z80/digitizer/software/digitizer/src/images/exec.jpeg

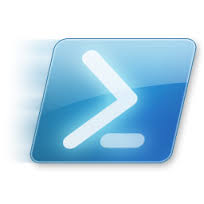
software/digitizer/src/images/exec.jpeg
