z80/digitizer/doc/socket 5 pin.pdf

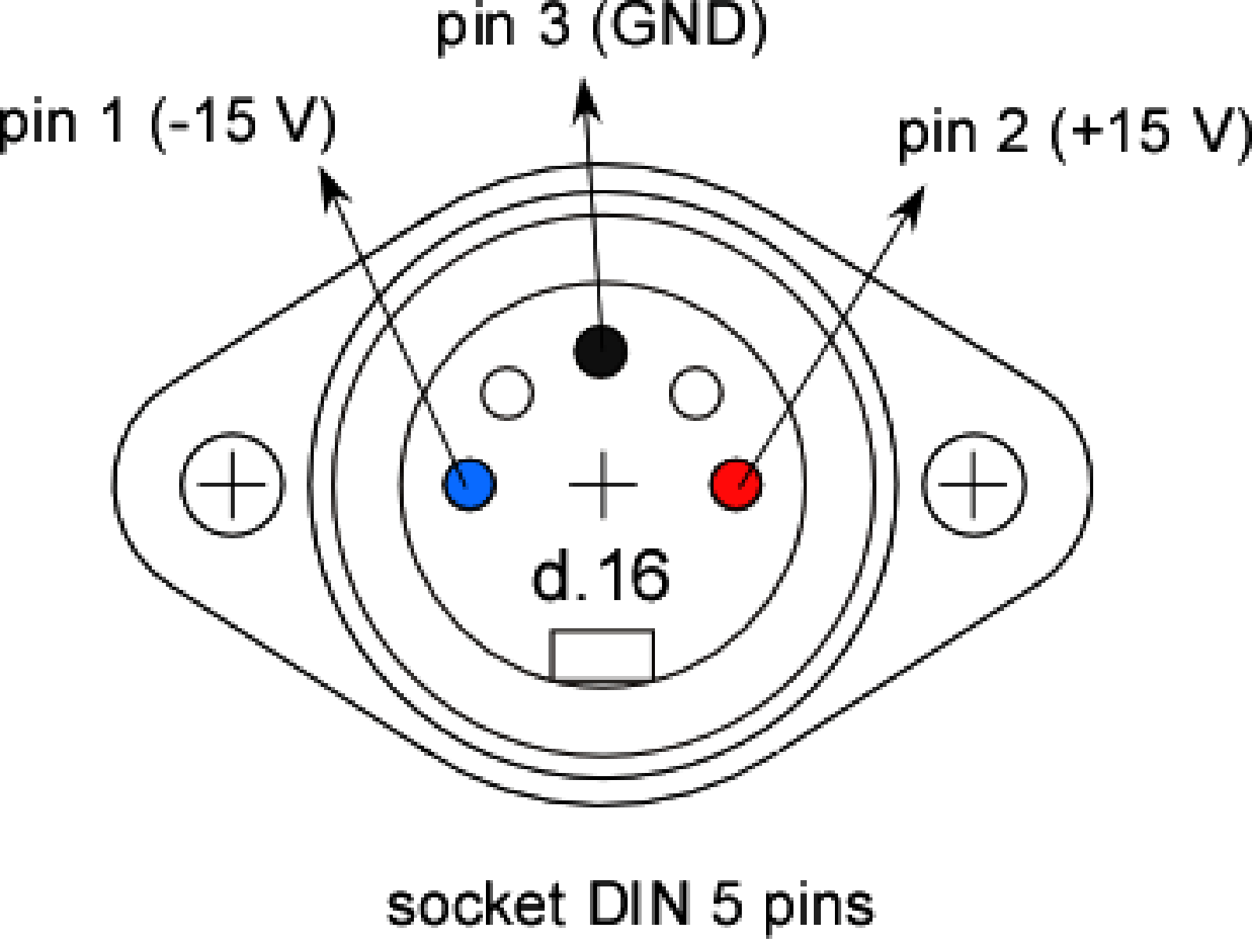
[picture p6: page 1]
