z80/digitizer/doc/mendeleev.jpg

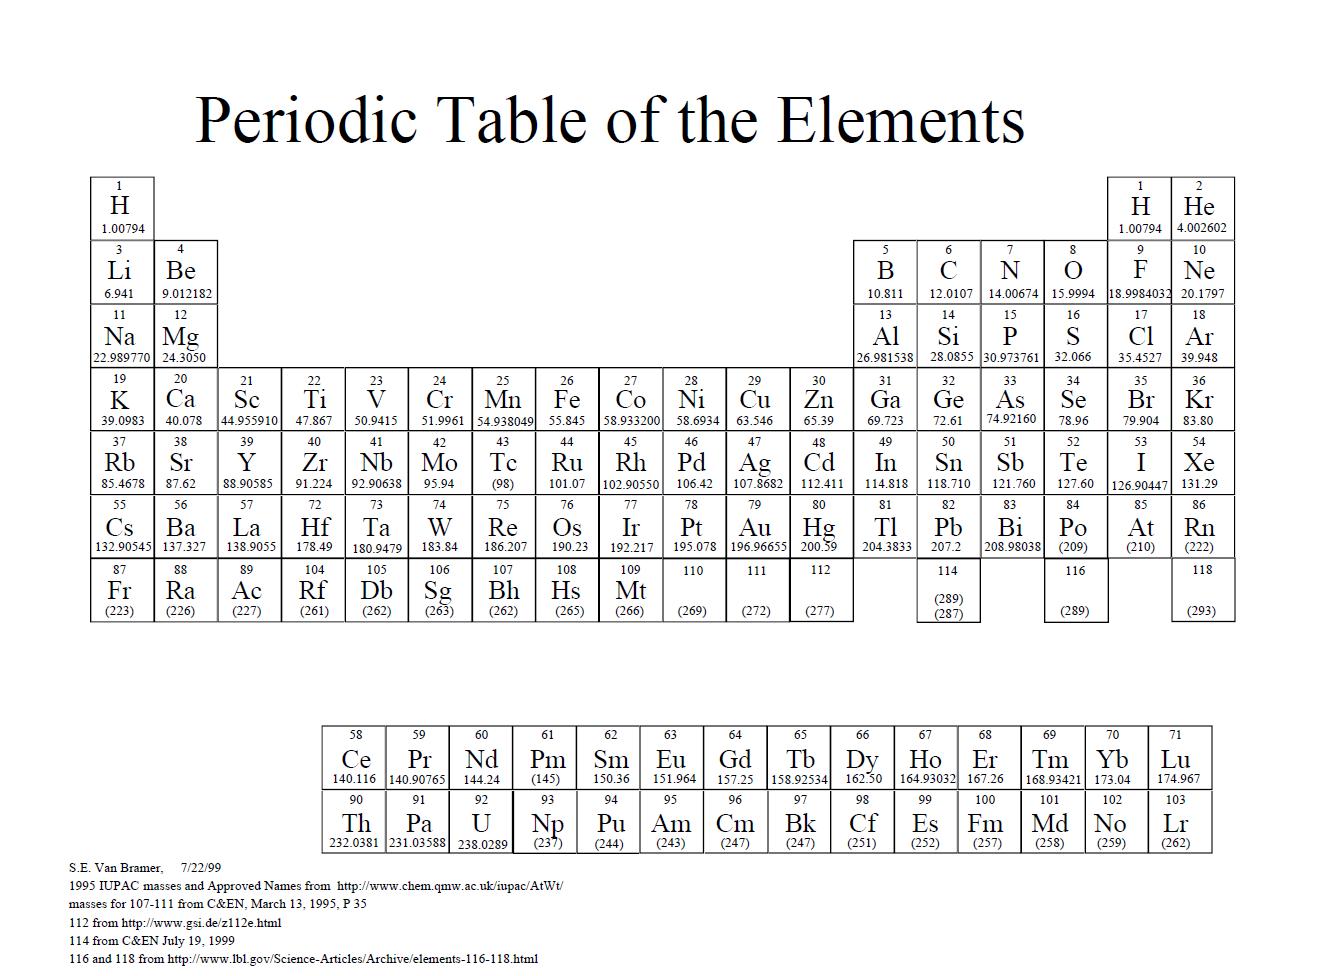
doc/mendeleev.jpg
