z80/digitizer/software/digitizer/src/images/out-relay.png

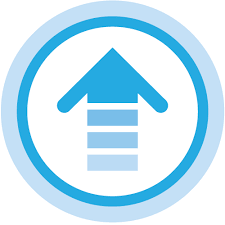
software/digitizer/src/images/out-relay.png
