z80/digitizer/software/help/content/html/about-dlg.png

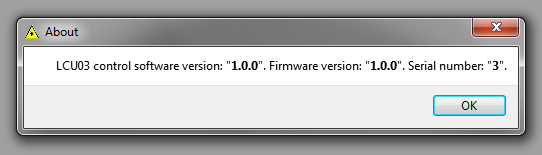
software/help/content/html/about-dlg.png
