z80/digitizer/software/help/content/html/device-selection.png

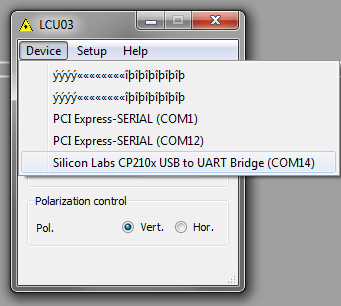
software/help/content/html/device-selection.png
