z80/digitizer/software/help/content/html/driver-folder.png

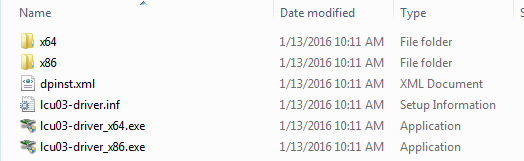
software/help/content/html/driver-folder.png
