z80/digitizer/software/help/content/html/firmware-upgrade.png

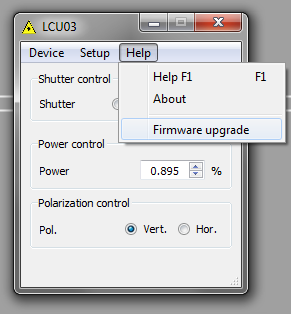
software/help/content/html/firmware-upgrade.png
