z80/digitizer/software/help/content/html/main-wnd.png

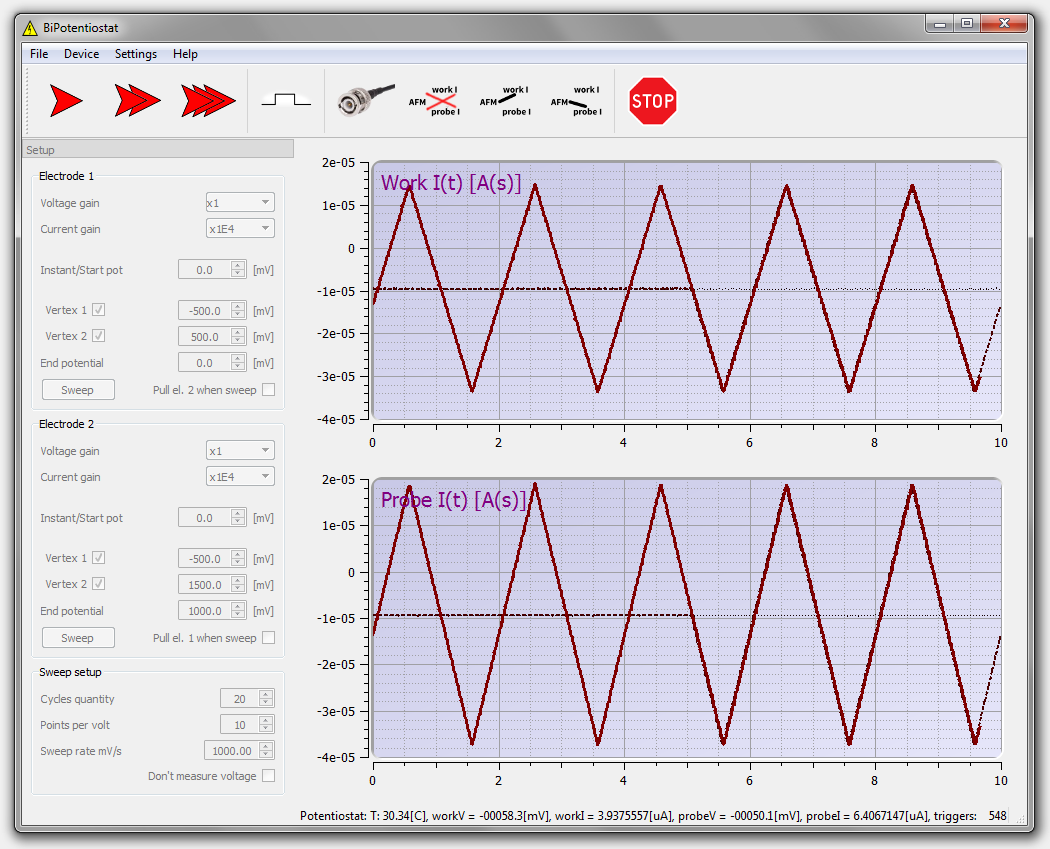
software/help/content/html/main-wnd.png
