z80/digitizer/software/help/content/html/remote-ctrl-dlg.png

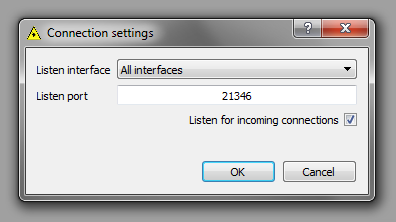
software/help/content/html/remote-ctrl-dlg.png
