z80/digitizer/software/help/content/html/sweep-wnd.png

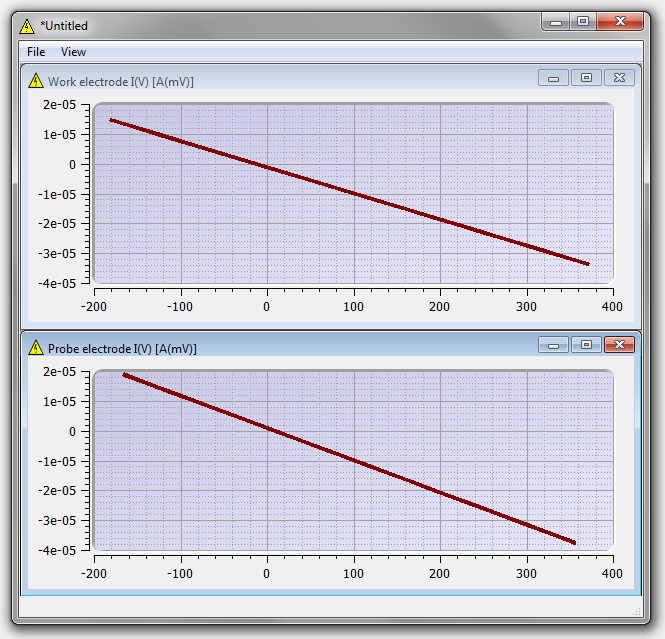
software/help/content/html/sweep-wnd.png
