z80/digitizer/doc/bnc-socket/031-5431-10rfx.igs

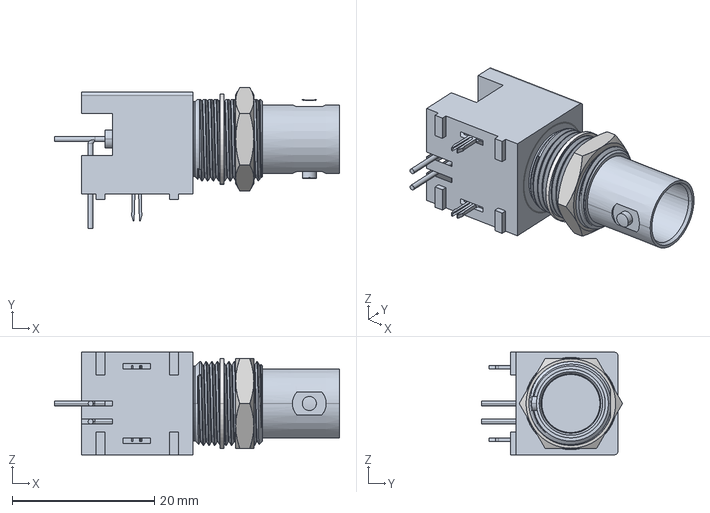
[picture p19: CAD file, 2015-08-29]
doc/bnc-socket/031-5431-10rfx.igs
40.0 x 19.8 x 14.4 mm
