z80/digitizer/drawing/bottom.stl

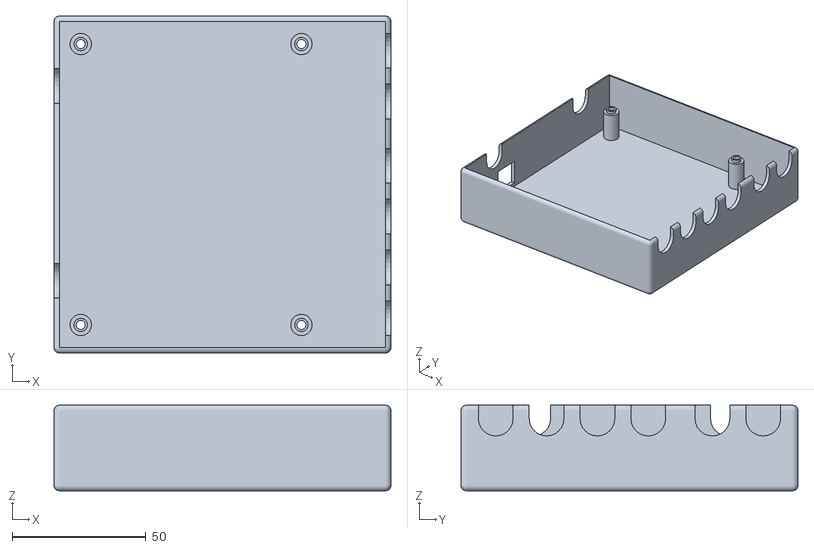
[picture p20: CAD file, 2015-08-29]
drawing/bottom.stl
126.0 x 126.0 x 32.0
