z80/digitizer/drawing/top.stl

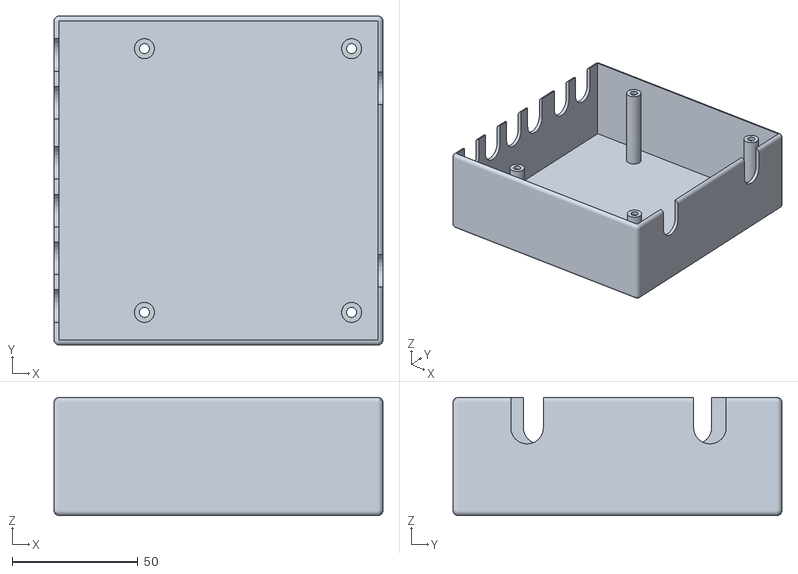
[picture p21: CAD file, 2015-08-29]
drawing/top.stl
131.0 x 131.0 x 47.0
