z80/digitizer/drawing/board.FCStd

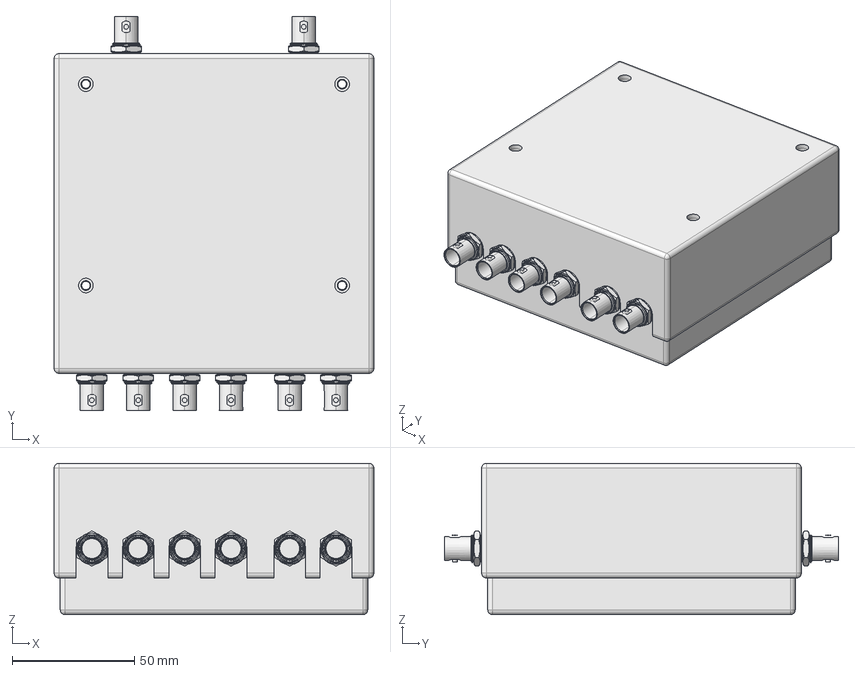
[picture p22: CAD file, 2015-08-29]
drawing/board.FCStd
131.0 x 161.4 x 62.0 mm
board
bnc
bnc02
bnc03
bnc04
bnc05
bnc06
bnc07
usb
bnc08
bottom-v02
top-v2
