z80/digitizer/drawing/washer.FCStd

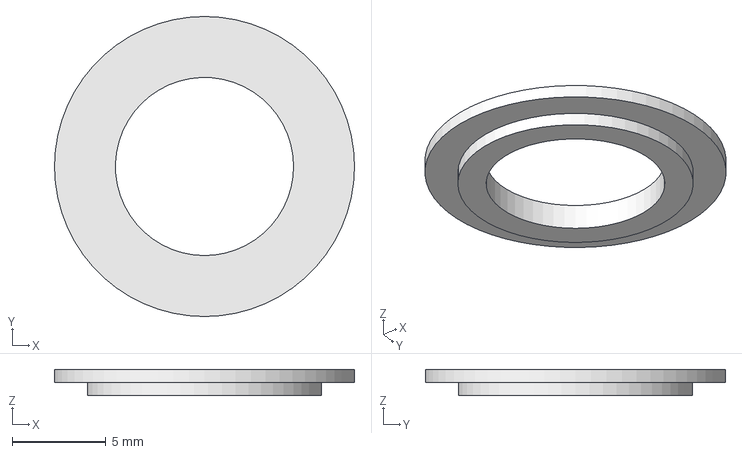
[picture p23: CAD file, 2015-08-29]
drawing/washer.FCStd
16.0 x 16.0 x 1.40 mm
