z80/digitizer/(list of files, cad)

Other CAD files:
firmware/chibios_2.4.x/demos/STM8L-STM8L152-DISCOVERY-STVD/cosmic/cosmic.stp
firmware/chibios_2.4.x/demos/STM8L-STM8L152-DISCOVERY-STVD/raisonance/raisonance.stp
firmware/chibios_2.4.x/demos/STM8S-STM8S105-DISCOVERY-STVD/cosmic/cosmic.stp
firmware/chibios_2.4.x/demos/STM8S-STM8S105-DISCOVERY-STVD/raisonance/raisonance.stp
firmware/chibios_2.4.x/testhal/STM8S/SPI/cosmic/cosmic.stp
firmware/chibios_2.4.x/testhal/STM8S/SPI/raisonance/raisonance.stp
firmware/digitizer/chibios_2.4.x/demos/STM8L-STM8L152-DISCOVERY-STVD/cosmic/cosmic.stp
firmware/digitizer/chibios_2.4.x/demos/STM8L-STM8L152-DISCOVERY-STVD/raisonance/raisonance.stp
firmware/digitizer/chibios_2.4.x/demos/STM8S-STM8S105-DISCOVERY-STVD/cosmic/cosmic.stp
firmware/digitizer/chibios_2.4.x/demos/STM8S-STM8S105-DISCOVERY-STVD/raisonance/raisonance.stp
firmware/digitizer/chibios_2.4.x/testhal/STM8S/SPI/cosmic/cosmic.stp
firmware/digitizer/chibios_2.4.x/testhal/STM8S/SPI/raisonance/raisonance.stp
drawing/washer.stl
