z80/digitizer/software/help/content/html/setup-dlg.png

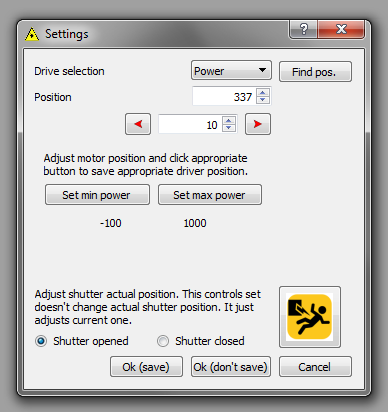
software/help/content/html/setup-dlg.png
