z80/digitizer/calc/adc-low-pass-filter.asc

C1: cap; 22n
C2: cap; 22n
C3: cap; 120n
C4: cap; 3.3µ
C5: cap; 60p
C6: cap; 3n
R1: res; 9.31k
R2: res; 21k
R3: res; 1.91k
R4: res; 806
R5: res; 10k
R6: res; 1.5k
R7: res; 10
R8: res; 3k
R9: res; 13k
R10: res; 10k
U1: UniversalOpamp2
U2: UniversalOpamp2
U3: UniversalOpamp2
U4: UniversalOpamp2
V1: voltage; SINE(0 10 3000); AC 1.
V2: voltage; 12
V3: voltage; 12
V4: voltage; PULSE(0 1 1u 0 0 1u 2u 100)
V5: voltage; 3.3
Named nets: 0, out, in, v+, v-, cmp, test, tst-in
.tran 20u
