z80/digitizer/electrical/relay-board/relay-board.kicad_pcb

## KiCad design electrical/relay-board/relay-board.kicad_pcb (2015-08-29)

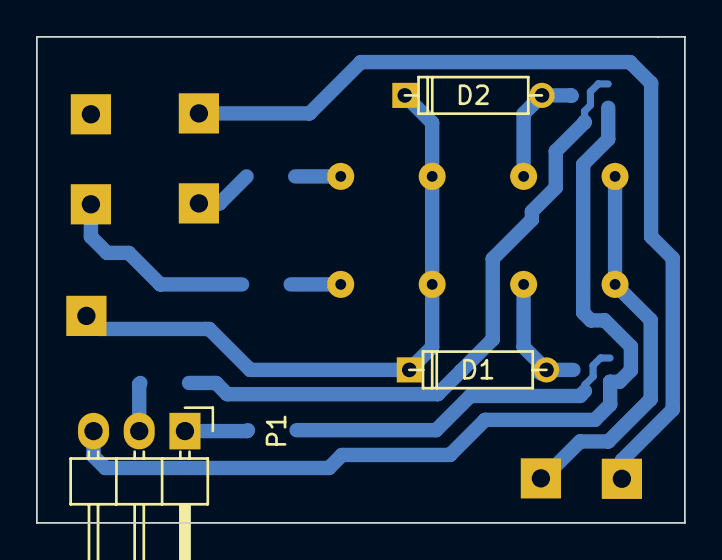
[picture p31: board relay-board.kicad_pcb from above]

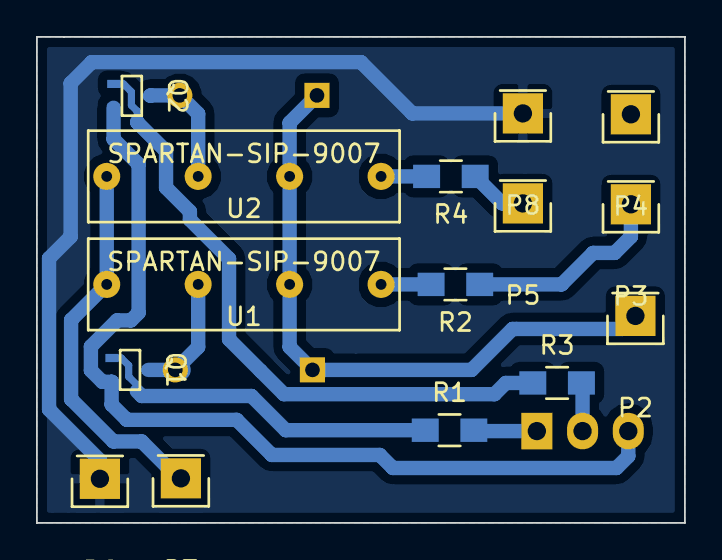
[picture p32: board relay-board.kicad_pcb from below]

Board: 2 copper layers, 36.0 x 27.0 mm, 18 parts (15 on the bottom side), 14 nets.

Parts:
D1, D2: 1n5819; D3
P1: CONN_01X03; Pin_Header_Angled_1x03
P2: 12V; Pin_Header_Straight_1x01
P3, P4: work; Pin_Header_Straight_1x01
P5, P6: probe; Pin_Header_Straight_1x01
P7: output; Pin_Header_Straight_1x01
P8: output gnd; Pin_Header_Straight_1x01
Q1, Q2: bc847; sot23
R1, R2, R3, R4: 1k 5%; R_0805_HandSoldering
U1, U2: SPARTAN-SIP-9007

Connections:
+12V: D1.1, D2.1, P2.1, U1.2, U2.2
/probeEn: P1.1, R1.2
/probeI: P3.1, R2.1
/workEn: P1.2, R3.2
/workI: P5.1, R4.1
GND: P1.3, Q1.3, Q2.3
GNDA: P6.1, P8.1
unnamed: D1.2, Q1.2, U1.3
unnamed: D2.2, Q2.2, U2.3
unnamed: P7.1, U1.4, U2.4
unnamed: Q1.1, R1.1
unnamed: Q2.1, R3.1
unnamed: R2.2, U1.1
unnamed: R4.2, U2.1
