z80/digitizer/electrical/scheme/digitizer.kicad_pcb

## KiCad design electrical/scheme/digitizer.kicad_pcb (2015-07-21)

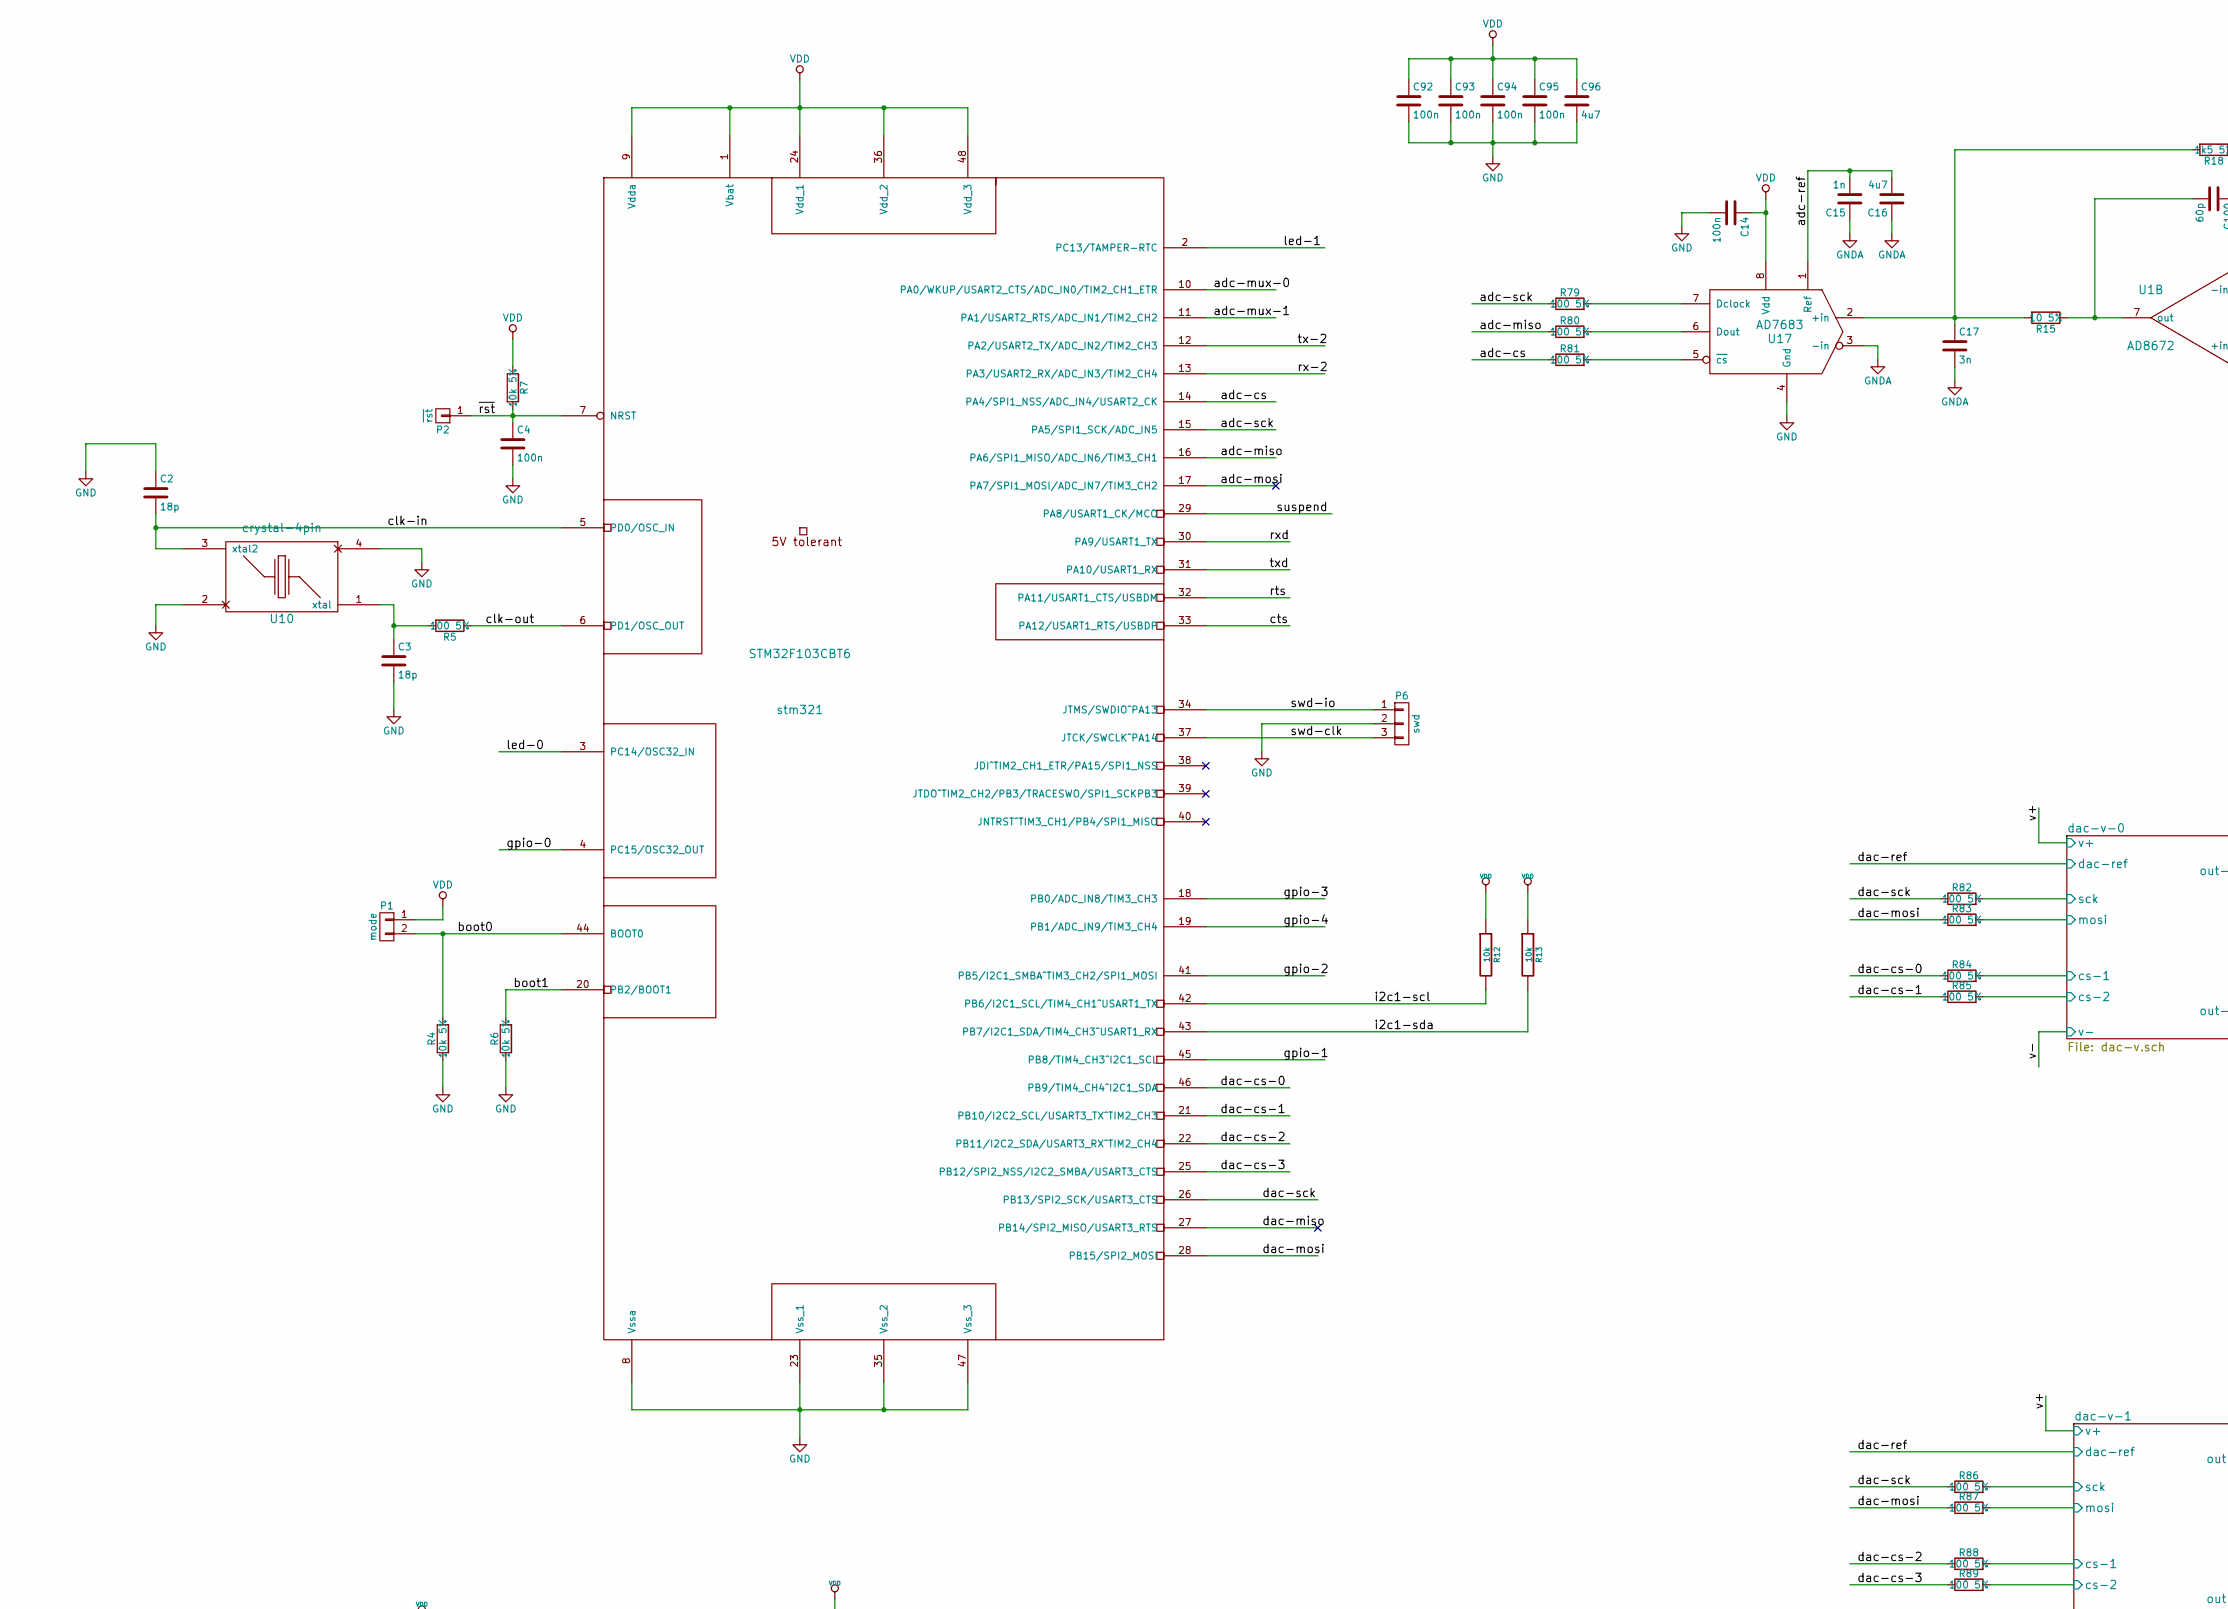
[picture p33: schematic digitizer.sch, part in row 1, column 1]

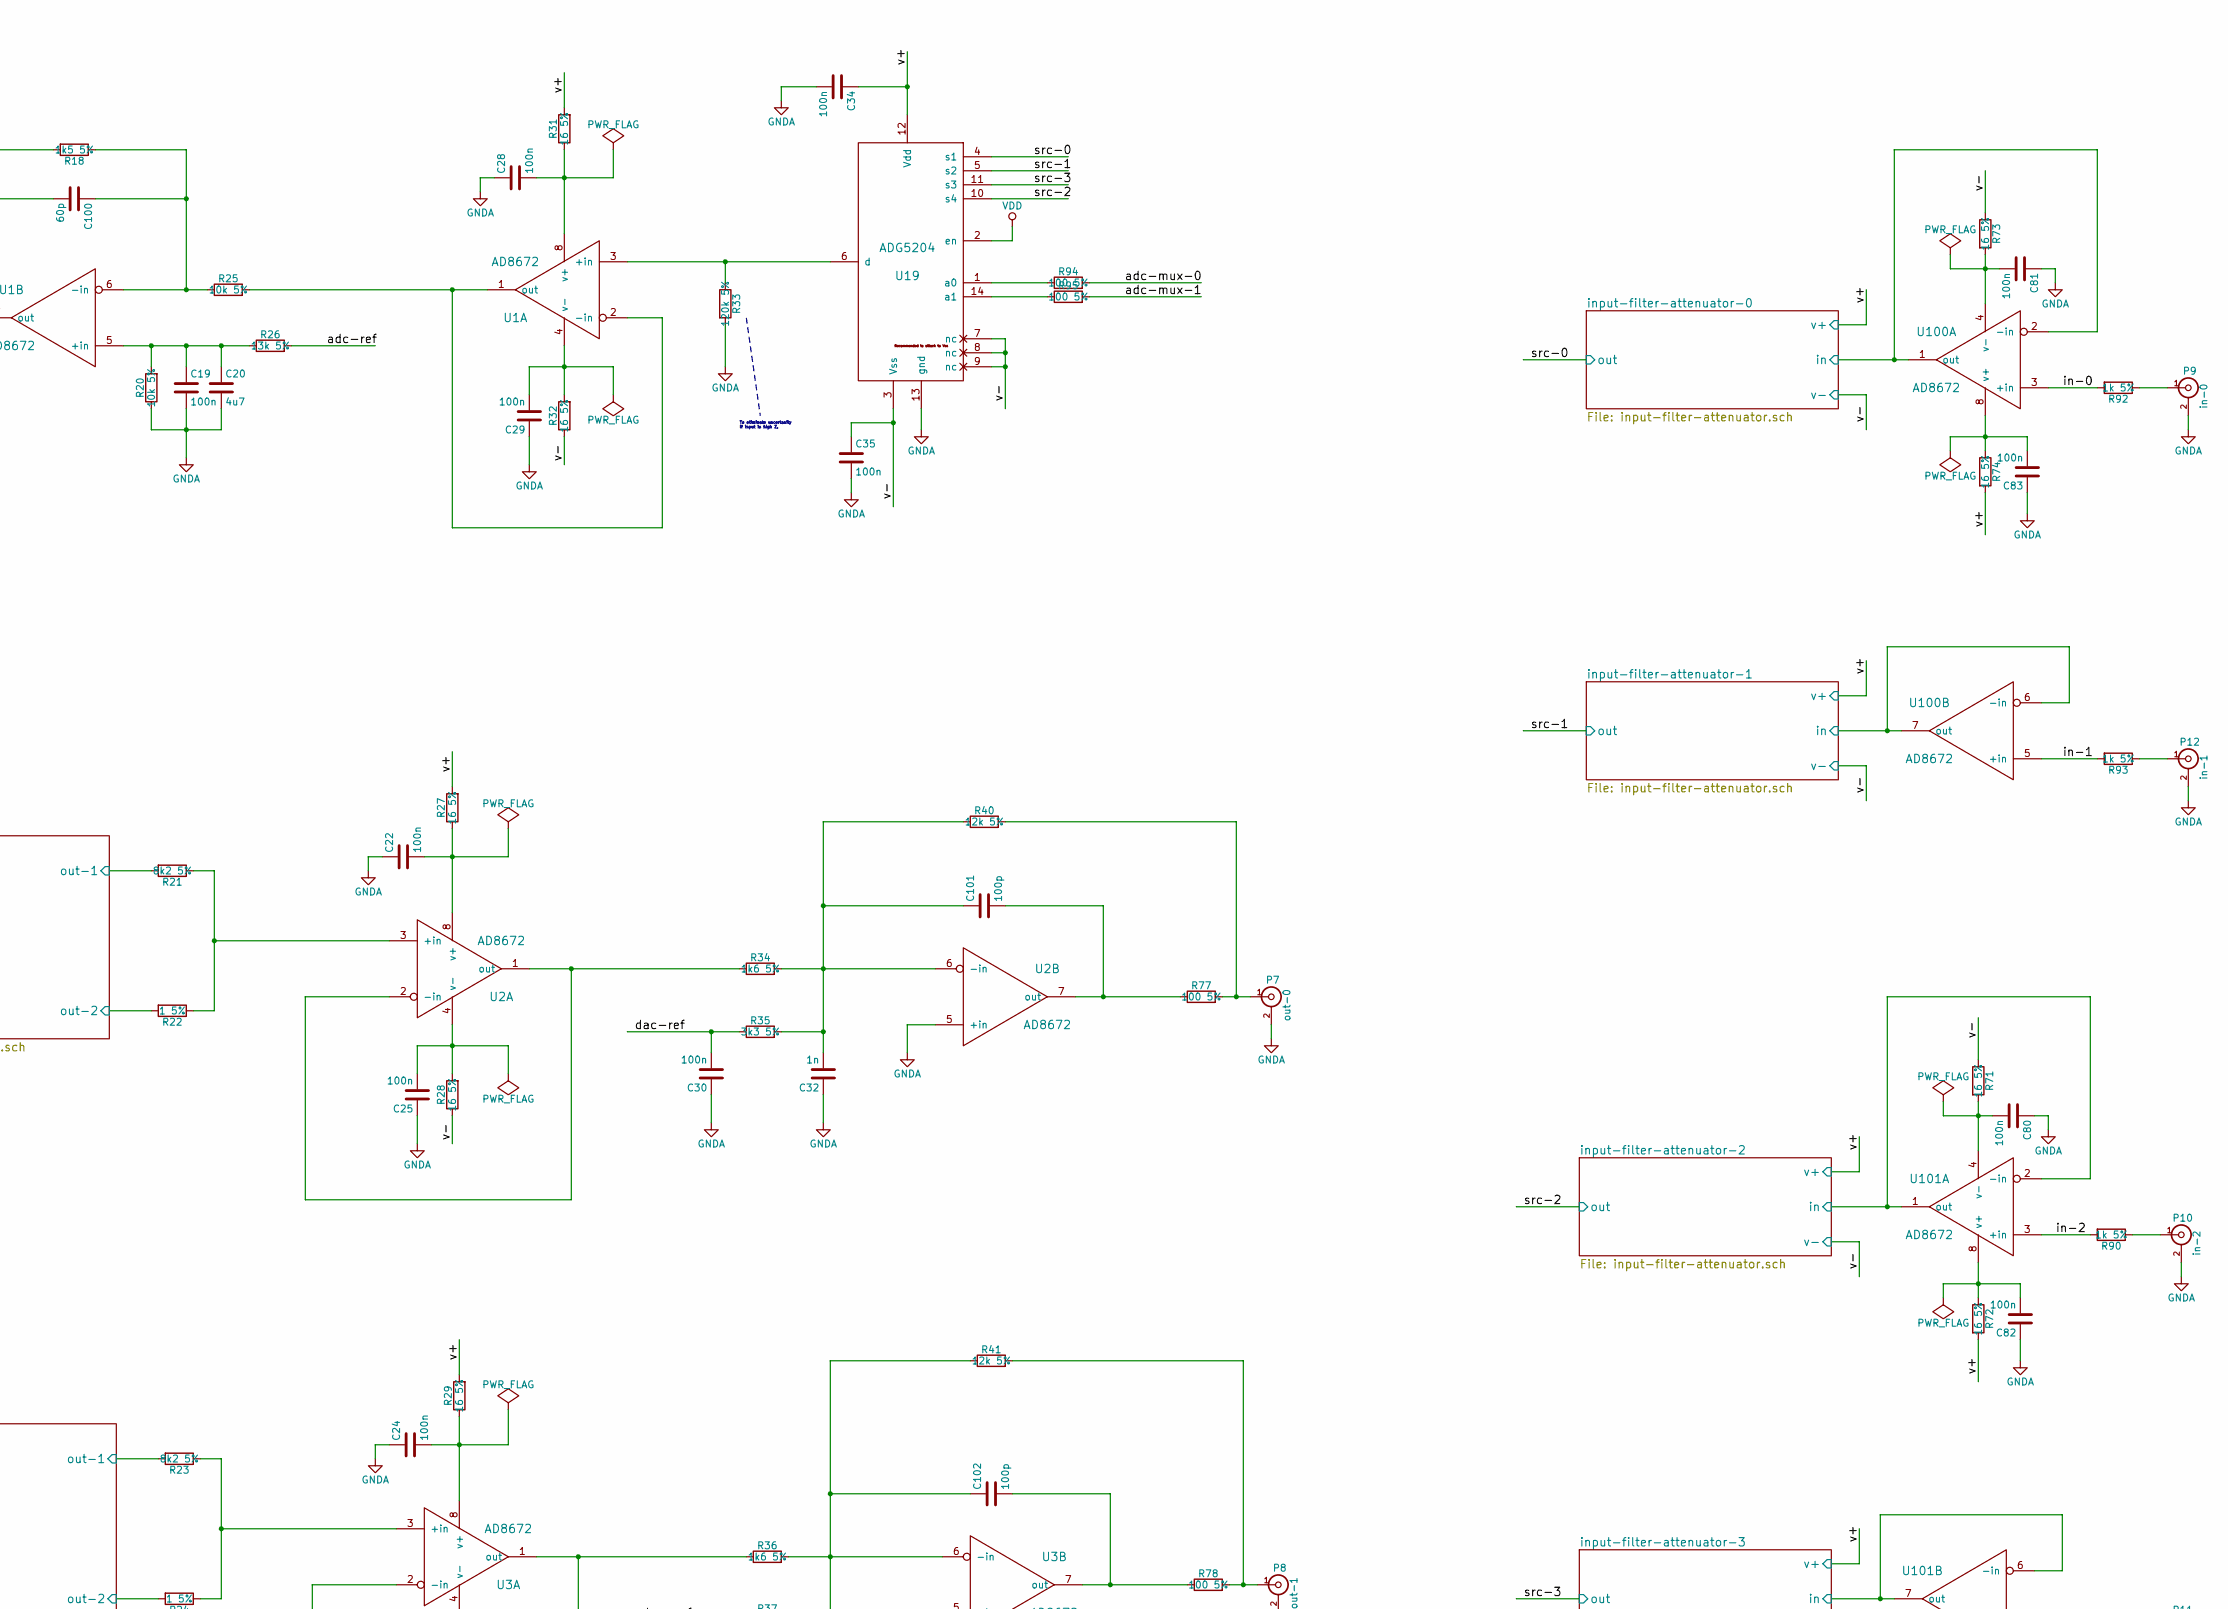
[picture p34: schematic digitizer.sch, part in row 1, column 2]

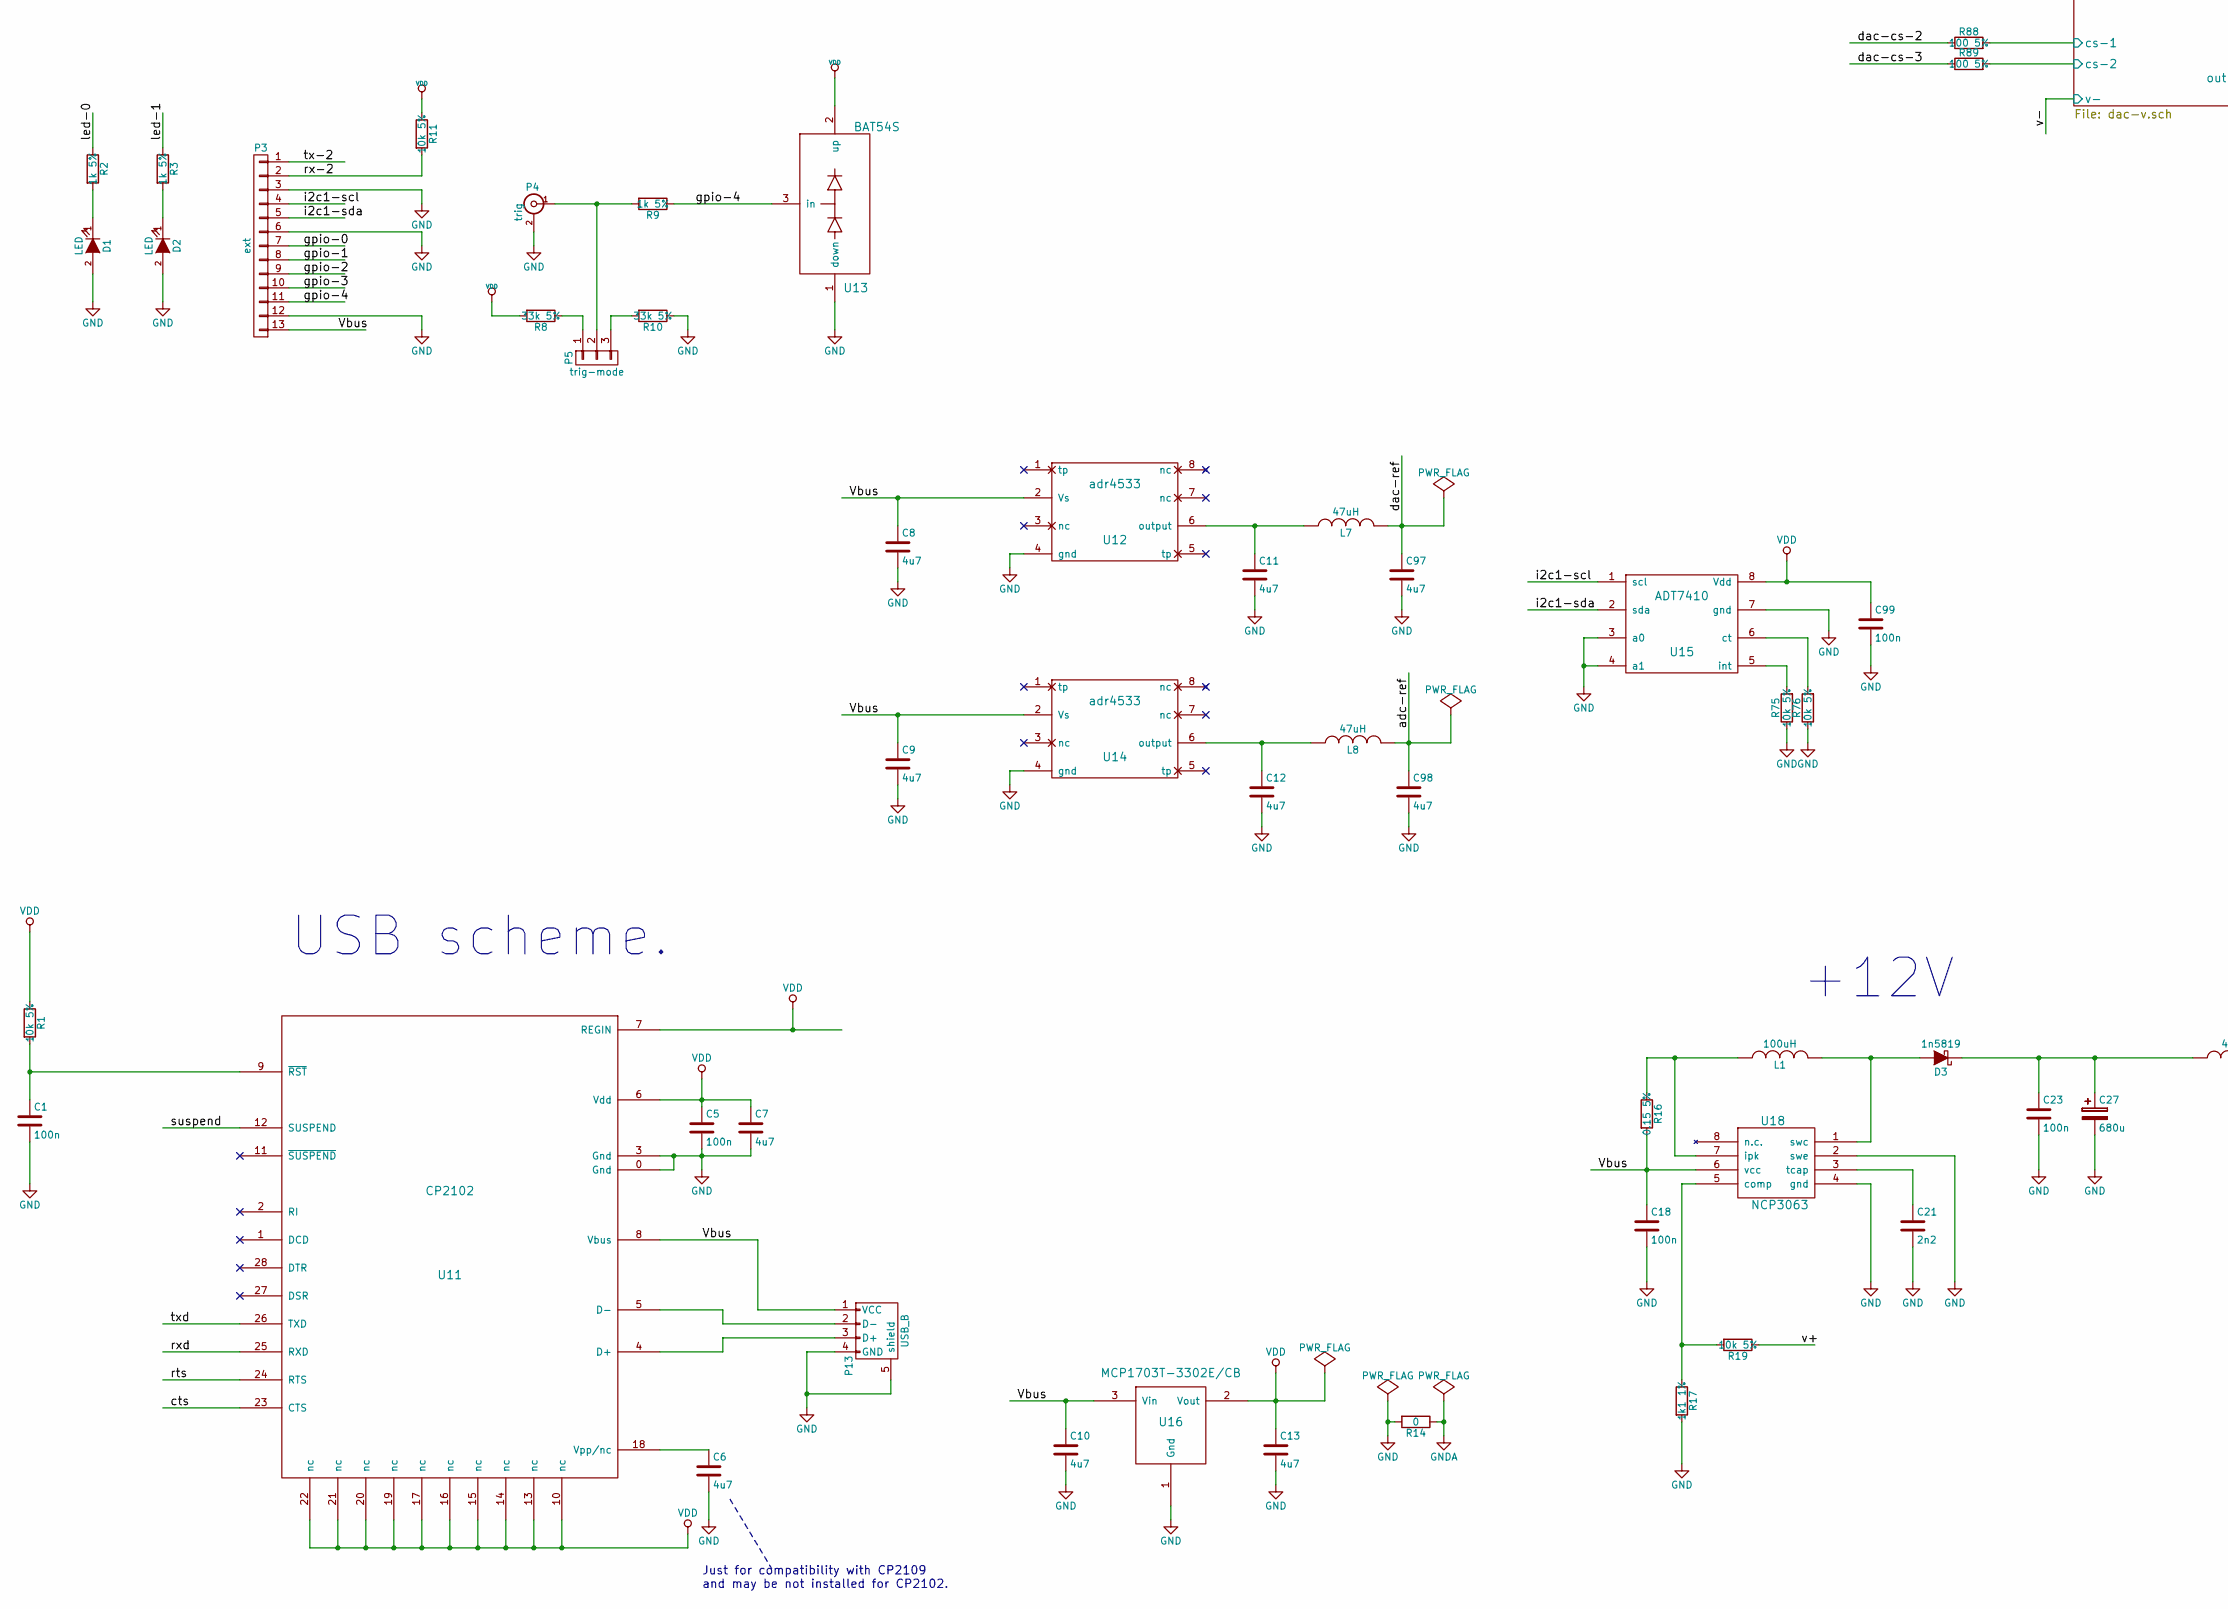
[picture p35: schematic digitizer.sch, part in row 2, column 1]

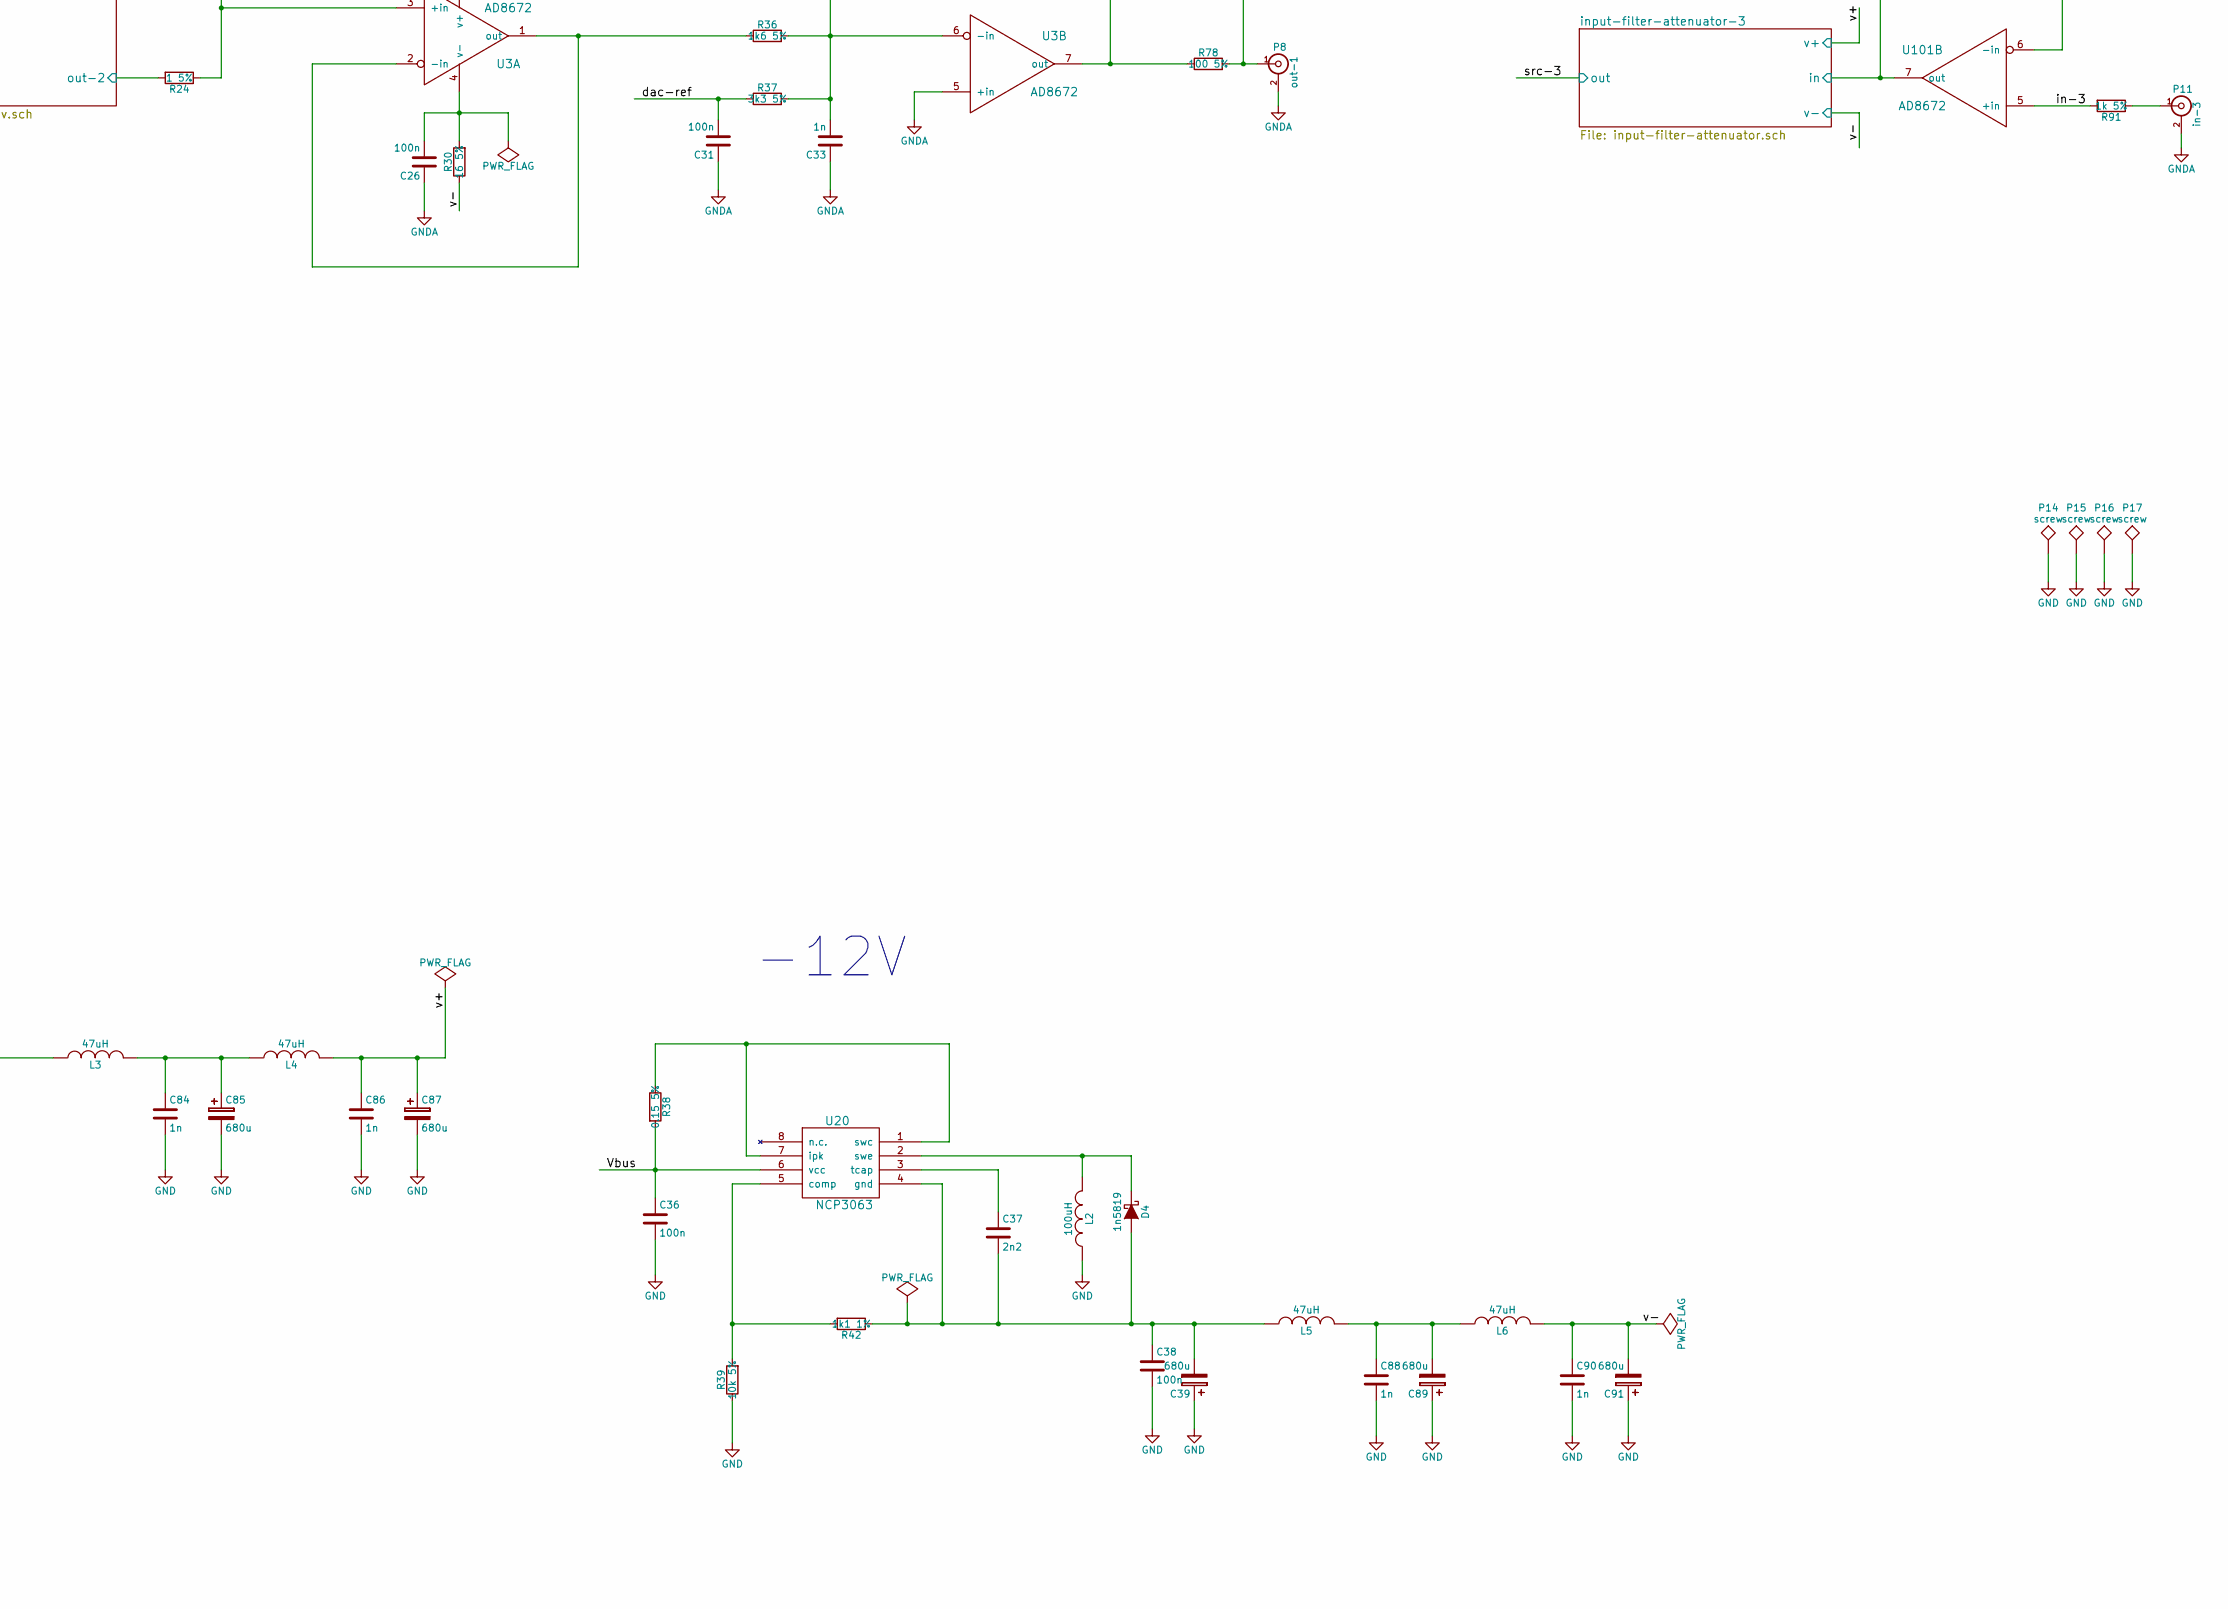
[picture p36: schematic digitizer.sch, part in row 2, column 2]

Parts:
C1, C4, C5, C14, C18, C19, C22, C23, C24, C25, C26, C28, C29, C30, C31, C34, C35, C36, C38, C80, C81, C82, C83, C92, C93, C94, C95, C99: 100n; C_0805_HandSoldering
C2, C3: 18p; C_0805_HandSoldering
C6, C7, C8, C9, C10, C11, C12, C13, C16, C20, C96, C97, C98: 4u7; C_0805_HandSoldering
C15, C32, C33, C84, C86, C88, C90: 1n; C_0805_HandSoldering
C17: 3n; C_0805_HandSoldering
C21, C37: 2n2; C_0805_HandSoldering
C27, C39, C85, C87, C89, C91: 680u; C_Radial_D10_L20_P5
C100: 60p; C_0805_HandSoldering
C101, C102: 100p; C_0805_HandSoldering
D1, D2: LED; LED-3MM
D3, D4: 1n5819; Diode_DO-41_SOD81_Horizontal_RM10
L1, L2: 100uH; my_inductance
L3, L4, L5, L6, L7, L8: 47uH; C_1206_HandSoldering
P1: mode; Pin_Header_Angled_1x02
P2: ~rst~; Pin_Header_Straight_1x01
P3: ext; Socket_Strip_Angled_1x13
P4: trig; BNC_Socket_TYCO-AMP_LargePads
P5: trig-mode; Pin_Header_Angled_1x03
P6: swd; Socket_Strip_Straight_1x03
P7: out-0; BNC_Socket_TYCO-AMP_LargePads
P8: out-1; BNC_Socket_TYCO-AMP_LargePads
P9: in-0; BNC_Socket_TYCO-AMP_LargePads
P10: in-2; BNC_Socket_TYCO-AMP_LargePads
P11: in-3; BNC_Socket_TYCO-AMP_LargePads
P12: in-1; BNC_Socket_TYCO-AMP_LargePads
P13: USB_B
P14, P15, P16, P17: screw; douille_4mm
R1, R4, R6, R7, R11, R19, R20, R25, R39, R75, R76: 10k 5%; R_0805_HandSoldering
R2, R3, R9, R90, R91, R92, R93: 1k 5%; R_0805_HandSoldering
R5, R77, R78, R79, R80, R81, R82, R83, R84, R85, R86, R87, R88, R89, R94, R95: 100 5%; R_0805_HandSoldering
R8, R10: 33k 5%; R_0805_HandSoldering
R12, R13: 10k; R_0805_HandSoldering
R14: 0; R_0805_HandSoldering
R15: 10 5%; R_0805_HandSoldering
R16, R38: 0.15 5%; R_0805_HandSoldering
R17, R42: 1k1 1%; R_0805_HandSoldering
R18: 1k5 5%; R_0805_HandSoldering
R21, R23: 8k2 5%; R_0805_HandSoldering
R22, R24: 1 5%; R_0805_HandSoldering
R26: 13k 5%; R_0805_HandSoldering
R27, R28, R29, R30, R31, R32, R71, R72, R73, R74: 16 5%; R_0805_HandSoldering
R33: 120k 5%; R_0805_HandSoldering
R34, R36: 1k6 5%; R_0805_HandSoldering
R35, R37: 3k3 5%; R_0805_HandSoldering
R40, R41: 12k 5%; R_0805_HandSoldering
U1, U2, U3, U100, U101: AD8672; SOIC-8_3.9x4.9mm_Pitch1.27mm
U10: crystal-4pin; CRYSTAL-SMD-5x3
U11: CP2102
U12, U14: adr4533; SOIC-8_3.9x4.9mm_Pitch1.27mm
U13: BAT54S; SOT-23
U15: ADT7410; SOIC-8_3.9x4.9mm_Pitch1.27mm
U16: MCP1703T-3302E/CB; SOT-23
U17: AD7683; MSOP-8_3x3mm_Pitch0.65mm
U18, U20: NCP3063; SOIC-8_3.9x4.9mm_Pitch1.27mm
U19: ADG5204; TSSOP-14_4.4x5mm_Pitch0.65mm
stm321: STM32F103CBT6; LQFP48

Connections:
/Vbus: C8.1, C9.1, C10.1, C18.1, C36.1, P3.13, P13.1 (VCC), R16.2, R38.2, U11.8 (Vbus), U12.2 (Vs), U14.2 (Vs), U16.3 (Vin), U18.6 (vcc), U20.6 (vcc)
/adc-cs: R81.1, stm321.14 (PA4/SPI1_NSS/ADC_IN4/USART2_CK)
/adc-miso: R80.1, stm321.16 (PA6/SPI1_MISO/ADC_IN6/TIM3_CH1)
/adc-mux-0: R94.2, stm321.10 (PA0/WKUP/USART2_CTS/ADC_IN0/TIM2_CH1_ETR)
/adc-mux-1: R95.2, stm321.11 (PA1/USART2_RTS/ADC_IN1/TIM2_CH2)
/adc-ref: C15.2, C16.2, C98.1, L8.2, R26.2, U17.1 (Ref)
/adc-sck: R79.1, stm321.15 (PA5/SPI1_SCK/ADC_IN5)
/boot0: P1.2, R4.2, stm321.44 (BOOT0)
/boot1: R6.2, stm321.20 (PB2/BOOT1)
/clk-in: C2.2, U10.3 (xtal2), stm321.5 (PD0/OSC_IN)
/clk-out: R5.1, stm321.6 (PD1/OSC_OUT)
/cts: U11.23 (CTS), stm321.33 (PA12/USART1_RTS/USBDP)
/dac-cs-0: R84.1, stm321.46 (PB9/TIM4_CH4^I2C1_SDA)
/dac-cs-1: R85.1, stm321.21 (PB10/I2C2_SCL/USART3_TX^TIM2_CH3)
/dac-cs-2: R88.1, stm321.22 (PB11/I2C2_SDA/USART3_RX^TIM2_CH4)
/dac-cs-3: R89.1, stm321.25 (PB12/SPI2_NSS/I2C2_SMBA/USART3_CTS)
/dac-mosi: R83.1, R87.1, stm321.28 (PB15/SPI2_MOSI)
/dac-sck: R82.1, R86.1, stm321.26 (PB13/SPI2_SCK/USART3_CTS)
/dac-v-0/cs-1: R84.2; also elsewhere on the board
/dac-v-0/cs-2: R85.2; also elsewhere on the board
/dac-v-0/dac-ref: C30.2, C31.2, C97.1, L7.2, R35.1, R37.1; also elsewhere on the board
/dac-v-0/mosi: R83.2; also elsewhere on the board
/dac-v-0/out-1: R21.2; also elsewhere on the board
/dac-v-0/out-2: R22.2; also elsewhere on the board
/dac-v-0/sck: R82.2; also elsewhere on the board
/dac-v-0/v+: C34.1, C86.1, C87.1, L4.2, R19.1, R27.2, R29.2, R31.2, R72.2, R74.2, U19.12 (Vdd); also elsewhere on the board
/dac-v-0/v-: C35.1, C90.1, C91.2, L6.2, R28.1, R30.1, R32.1, R71.1, R73.1, U19.3 (Vss), U19.7 (nc), U19.8 (nc), U19.9 (nc); also elsewhere on the board
/dac-v-1/cs-1: R88.2; also elsewhere on the board
/dac-v-1/cs-2: R89.2; also elsewhere on the board
/dac-v-1/mosi: R87.2; also elsewhere on the board
/dac-v-1/out-1: R23.2; also elsewhere on the board
/dac-v-1/out-2: R24.2; also elsewhere on the board
/dac-v-1/sck: R86.2; also elsewhere on the board
/gpio-0: P3.7, stm321.4 (PC15/OSC32_OUT)
/gpio-1: P3.8, stm321.45 (PB8/TIM4_CH3^I2C1_SCL)
/gpio-2: P3.9, stm321.41 (PB5/I2C1_SMBA^TIM3_CH2/SPI1_MOSI)
/gpio-3: P3.10, stm321.18 (PB0/ADC_IN8/TIM3_CH3)
/gpio-4: P3.11, R9.1, U13.3 (in), stm321.19 (PB1/ADC_IN9/TIM3_CH4)
/i2c1-scl: P3.4, R12.2, U15.1 (scl), stm321.42 (PB6/I2C1_SCL/TIM4_CH1^USART1_TX)
/i2c1-sda: P3.5, R13.2, U15.2 (sda), stm321.43 (PB7/I2C1_SDA/TIM4_CH3^USART1_RX)
/in-0: R92.2, U100.3 (+in)
/in-1: R93.2, U100.5 (+in)
/in-2: R90.2, U101.3 (+in)
/in-3: R91.2, U101.5 (+in)
/input-filter-attenuator-0/in: U100.1 (out), U100.2 (-in); also elsewhere on the board
/input-filter-attenuator-0/out: U19.4 (s1); also elsewhere on the board
/input-filter-attenuator-1/in: U100.6 (-in), U100.7 (out); also elsewhere on the board
/input-filter-attenuator-1/out: U19.5 (s2); also elsewhere on the board
/input-filter-attenuator-2/in: U101.1 (out), U101.2 (-in); also elsewhere on the board
/input-filter-attenuator-2/out: U19.10 (s4); also elsewhere on the board
/input-filter-attenuator-3/in: U101.6 (-in), U101.7 (out); also elsewhere on the board
/input-filter-attenuator-3/out: U19.11 (s3); also elsewhere on the board
/led-0: R2.1, stm321.3 (PC14/OSC32_IN)
/led-1: R3.1, stm321.2 (PC13/TAMPER-RTC)
/rts: U11.24 (RTS), stm321.32 (PA11/USART1_CTS/USBDM)
/rx-2: P3.2, R11.2, stm321.13 (PA3/USART2_RX/ADC_IN3/TIM2_CH4)
/rxd: U11.25 (RXD), stm321.30 (PA9/USART1_TX)
/suspend: U11.12 (SUSPEND), stm321.29 (PA8/USART1_CK/MCO)
/swd-clk: P6.3, stm321.37 (JTCK/SWCLK^PA14)
/swd-io: P6.1, stm321.34 (JTMS/SWDIO^PA13)
/tx-2: P3.1, stm321.12 (PA2/USART2_TX/ADC_IN2/TIM2_CH3)
/txd: U11.26 (TXD), stm321.31 (PA10/USART1_RX)
/~rst~: C4.1, P2.1, R7.2, stm321.7 (NRST)
GND: C1.2, C2.1, C3.2, C4.2, C5.2, C6.2, C7.2, C8.2, C9.2, C10.2, C11.2, C12.2, C13.2, C14.2, C18.2, C21.2, C23.2, C27.2, C36.2, C38.2, C39.1, C84.2, C85.2, C86.2, C87.2, C88.2, C89.1, C90.2, C91.1, C92.2, C93.2, C94.2, C95.2, C96.2, C97.2, C98.2, C99.2, D1.2 (A), D2.2 (A), L2.1, P3.3, P3.6, P3.12, P4.2 (Ext), P6.2, P13.4 (GND), P13.5 (shield), P14.1, P15.1, P16.1, P17.1, R4.1, R6.1, R10.1, R14.2, R17.2, R39.1, R75.1, R76.1, U10.2, U10.4, U11.0 (Gnd), U11.3 (Gnd), U12.4 (gnd), U13.1 (down), U14.4 (gnd), U15.3 (a0), U15.4 (a1), U15.7 (gnd), U16.1 (Gnd), U17.4 (Gnd), U18.2 (swe), U18.4 (gnd), stm321.8 (Vssa), stm321.23 (Vss_1), stm321.35 (Vss_2), stm321.47 (Vss_3); also elsewhere on the board
GNDA: C15.1, C16.1, C17.2, C19.2, C20.2, C22.1, C24.1, C25.1, C26.1, C28.1, C29.1, C30.1, C31.1, C32.1, C33.1, C34.2, C35.2, C80.1, C81.1, C82.1, C83.1, P7.2 (Ext), P8.2 (Ext), P9.2 (Ext), P10.2 (Ext), P11.2 (Ext), P12.2 (Ext), R14.1, R20.1, R33.2, U2.5 (+in), U3.5 (+in), U17.3 (-in), U19.13 (gnd); also elsewhere on the board
unnamed: C1.1, R1.2, U11.9 (~RST~)
unnamed: C3.1, R5.2, U10.1 (xtal)
unnamed: C6.1, U11.18 (Vpp/nc)
unnamed: C11.1, L7.1, U12.6 (output)
unnamed: C12.1, L8.1, U14.6 (output)
unnamed: C17.1, R15.2, R18.2, U17.2 (+in)
unnamed: C19.1, C20.1, R20.2, R26.1, U1.5 (+in)
unnamed: C21.1, U18.3 (tcap)
unnamed: C22.2, R27.1, U2.8 (v+)
unnamed: C23.1, C27.1, D3.1 (K), L3.1
unnamed: C24.2, R29.1, U3.8 (v+)
unnamed: C25.2, R28.2, U2.4 (v-)
unnamed: C26.2, R30.2, U3.4 (v-)
unnamed: C28.2, R31.1, U1.8 (v+)
unnamed: C29.2, R32.2, U1.4 (v-)
unnamed: C37.1, U20.3 (tcap)
unnamed: C37.2, C38.1, C39.2, D4.2 (A), L5.1, R42.1, U20.4 (gnd)
unnamed: C80.2, R71.2, U101.4 (v-)
unnamed: C81.2, R73.2, U100.4 (v-)
unnamed: C82.2, R72.1, U101.8 (v+)
unnamed: C83.2, R74.1, U100.8 (v+)
unnamed: C84.1, C85.1, L3.2, L4.1
unnamed: C88.1, C89.2, L5.2, L6.1
unnamed: C100.1, R18.1, R25.1, U1.6 (-in)
unnamed: C100.2, R15.1, U1.7 (out)
unnamed: C32.2, C101.1, R34.2, R35.2, R40.1, U2.6 (-in)
unnamed: C101.2, R77.1, U2.7 (out)
unnamed: C33.2, C102.1, R36.2, R37.2, R41.1, U3.6 (-in)
unnamed: C102.2, R78.1, U3.7 (out)
unnamed: D1.1 (K), R2.2
unnamed: D2.1 (K), R3.2
unnamed: D3.2 (A), L1.2, U18.1 (swc)
unnamed: D4.1 (K), L2.2, U20.2 (swe)
unnamed: L1.1, R16.1, U18.7 (ipk)
unnamed: P4.1 (In), P5.2, R9.2
unnamed: P5.1, R8.1
unnamed: P5.3, R10.2
unnamed: P7.1 (In), R40.2, R77.2
unnamed: P8.1 (In), R41.2, R78.2
unnamed: P9.1 (In), R92.1
unnamed: P10.1 (In), R90.1
unnamed: P11.1 (In), R91.1
unnamed: P12.1 (In), R93.1
unnamed: P13.2 (D-), U11.5 (D-)
unnamed: P13.3 (D+), U11.4 (D+)
unnamed: R17.1, R19.2, U18.5 (comp)
unnamed: R21.1, R22.1, U2.3 (+in)
unnamed: R23.1, R24.1, U3.3 (+in)
unnamed: R25.2, U1.1 (out), U1.2 (-in)
unnamed: R33.1, U1.3 (+in), U19.6 (d)
unnamed: R34.1, U2.1 (out), U2.2 (-in)
unnamed: R36.1, U3.1 (out), U3.2 (-in)
unnamed: R38.1, U20.1 (swc), U20.7 (ipk)
unnamed: R39.2, R42.2, U20.5 (comp)
unnamed: R75.2, U15.5 (int)
unnamed: R76.2, U15.6 (ct)
unnamed: R79.2, U17.7 (Dclock)
unnamed: R80.2, U17.6 (Dout)
unnamed: R81.2, U17.5 (~cs~)
unnamed: R94.1, U19.1 (a0)
unnamed: R95.1, U19.14 (a1)
VDD: C5.1, C7.1, C13.1, C14.1, C92.1, C93.1, C94.1, C95.1, C96.1, C99.1, P1.1, R1.1, R7.1, R8.2, R11.1, R12.1, R13.1, U11.6 (Vdd), U11.7 (REGIN), U11.10 (nc), U11.13 (nc), U11.14 (nc), U11.15 (nc), U11.16 (nc), U11.17 (nc), U11.19 (nc), U11.20 (nc), U11.21 (nc), U11.22 (nc), U13.2 (up), U15.8 (Vdd), U16.2 (Vout), U17.8 (Vdd), U19.2 (en), stm321.1 (Vbat), stm321.9 (Vdda), stm321.24 (Vdd_1), stm321.36 (Vdd_2), stm321.48 (Vdd_3); also elsewhere on the board

Notes on the sheet:
+12V
-12V
Just for compatibility with CP2109 and may be not installed for CP2102.
USB scheme.
To eliminate uncertanity if input is high Z.
