z80/digitizer/electrical/scheme/digitizer.kicad_pcb

## KiCad design electrical/scheme/digitizer.kicad_pcb (continued)

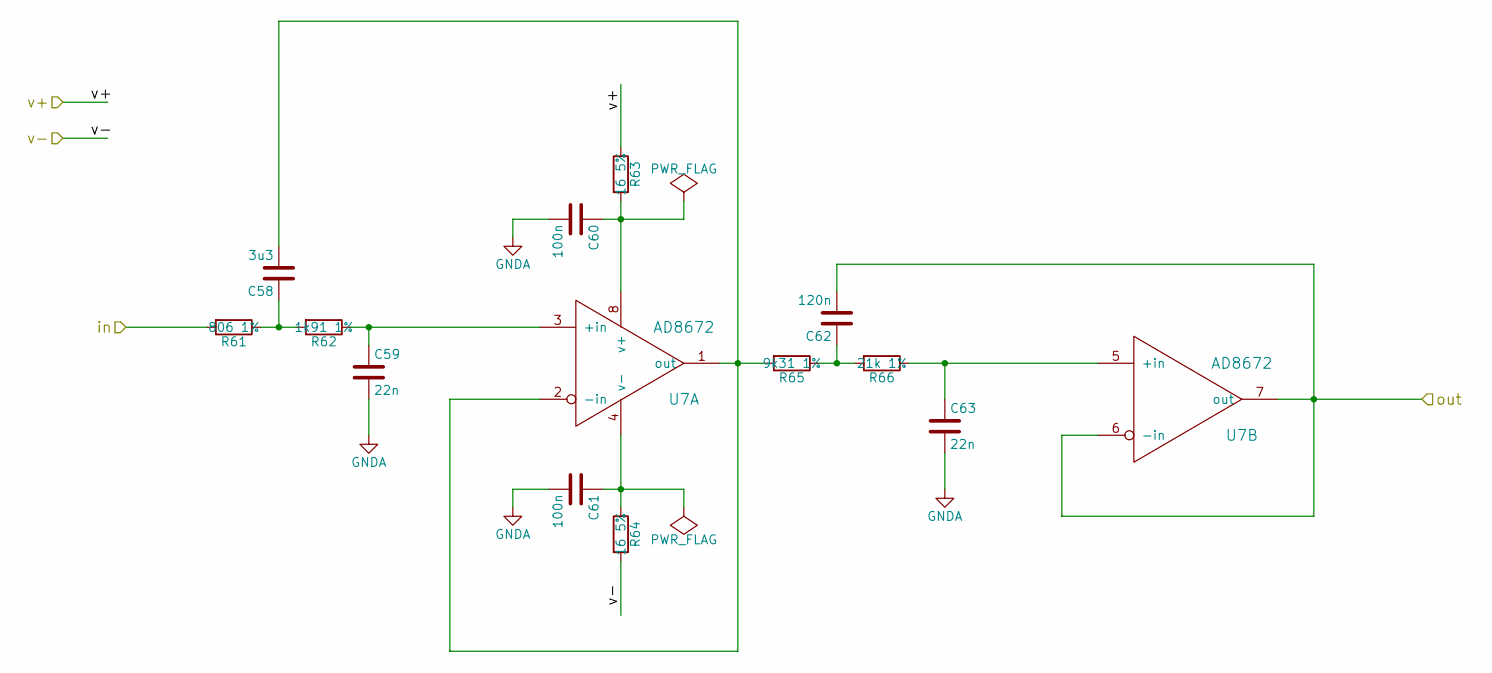
[picture p37: schematic input-filter-attenuator.sch]

Parts:
C40: 3u3; C_0805_HandSoldering
C41, C45: 22n; C_0805_HandSoldering
C42, C43: 100n; C_0805_HandSoldering
C44: 120n; C_0805_HandSoldering
R43: 806 1%; R_0805_HandSoldering
R44: 1k91 1%; R_0805_HandSoldering
R45, R46: 16 5%; R_0805_HandSoldering
R47: 9k31 1%; R_0805_HandSoldering
R48: 21k 1%; R_0805_HandSoldering
U4: AD8672; SOIC-8_3.9x4.9mm_Pitch1.27mm

Connections:
/dac-v-0/v+: R45.1; also elsewhere on the board
/dac-v-0/v-: R46.2; also elsewhere on the board
/input-filter-attenuator-0/in: R43.2; also elsewhere on the board
/input-filter-attenuator-0/out: C44.2, U4.6 (-in), U4.7 (out); also elsewhere on the board
GNDA: C41.2, C42.2, C43.2, C45.2; also elsewhere on the board
unnamed: C40.1, R43.1, R44.2
unnamed: C40.2, R47.2, U4.1 (out), U4.2 (-in)
unnamed: C41.1, R44.1, U4.3 (+in)
unnamed: C42.1, R45.2, U4.8 (v+)
unnamed: C43.1, R46.1, U4.4 (v-)
unnamed: C44.1, R47.1, R48.2
unnamed: C45.1, R48.1, U4.5 (+in)

Parts of its further copies:
C46, C52, C58: 3u3; C_0805_HandSoldering
C47, C51, C53, C57, C59, C63: 22n; C_0805_HandSoldering
C48, C49, C54, C55, C60, C61: 100n; C_0805_HandSoldering
C50, C56, C62: 120n; C_0805_HandSoldering
R49, R55, R61: 806 1%; R_0805_HandSoldering
R50, R56, R62: 1k91 1%; R_0805_HandSoldering
R51, R52, R57, R58, R63, R64: 16 5%; R_0805_HandSoldering
R53, R59, R65: 9k31 1%; R_0805_HandSoldering
R54, R60, R66: 21k 1%; R_0805_HandSoldering
U5, U6, U7: AD8672; SOIC-8_3.9x4.9mm_Pitch1.27mm

Connections of its further copies:
/dac-v-0/v+: R51.1, R57.1, R63.1; also elsewhere on the board
/dac-v-0/v-: R52.2, R58.2, R64.2; also elsewhere on the board
/input-filter-attenuator-1/in: R49.2; also elsewhere on the board
/input-filter-attenuator-1/out: C50.2, U5.6 (-in), U5.7 (out); also elsewhere on the board
/input-filter-attenuator-2/in: R55.2; also elsewhere on the board
/input-filter-attenuator-2/out: C56.2, U6.6 (-in), U6.7 (out); also elsewhere on the board
/input-filter-attenuator-3/in: R61.2; also elsewhere on the board
/input-filter-attenuator-3/out: C62.2, U7.6 (-in), U7.7 (out); also elsewhere on the board
GNDA: C47.2, C48.2, C49.2, C51.2, C53.2, C54.2, C55.2, C57.2, C59.2, C60.2, C61.2, C63.2; also elsewhere on the board
unnamed: C46.1, R49.1, R50.2
unnamed: C46.2, R53.2, U5.1 (out), U5.2 (-in)
unnamed: C47.1, R50.1, U5.3 (+in)
unnamed: C48.1, R51.2, U5.8 (v+)
unnamed: C49.1, R52.1, U5.4 (v-)
unnamed: C50.1, R53.1, R54.2
unnamed: C51.1, R54.1, U5.5 (+in)
unnamed: C52.1, R55.1, R56.2
unnamed: C52.2, R59.2, U6.1 (out), U6.2 (-in)
unnamed: C53.1, R56.1, U6.3 (+in)
unnamed: C54.1, R57.2, U6.8 (v+)
unnamed: C55.1, R58.1, U6.4 (v-)
unnamed: C56.1, R59.1, R60.2
unnamed: C57.1, R60.1, U6.5 (+in)
unnamed: C58.1, R61.1, R62.2
unnamed: C58.2, R65.2, U7.1 (out), U7.2 (-in)
unnamed: C59.1, R62.1, U7.3 (+in)
unnamed: C60.1, R63.2, U7.8 (v+)
unnamed: C61.1, R64.1, U7.4 (v-)
unnamed: C62.1, R65.1, R66.2
unnamed: C63.1, R66.1, U7.5 (+in)

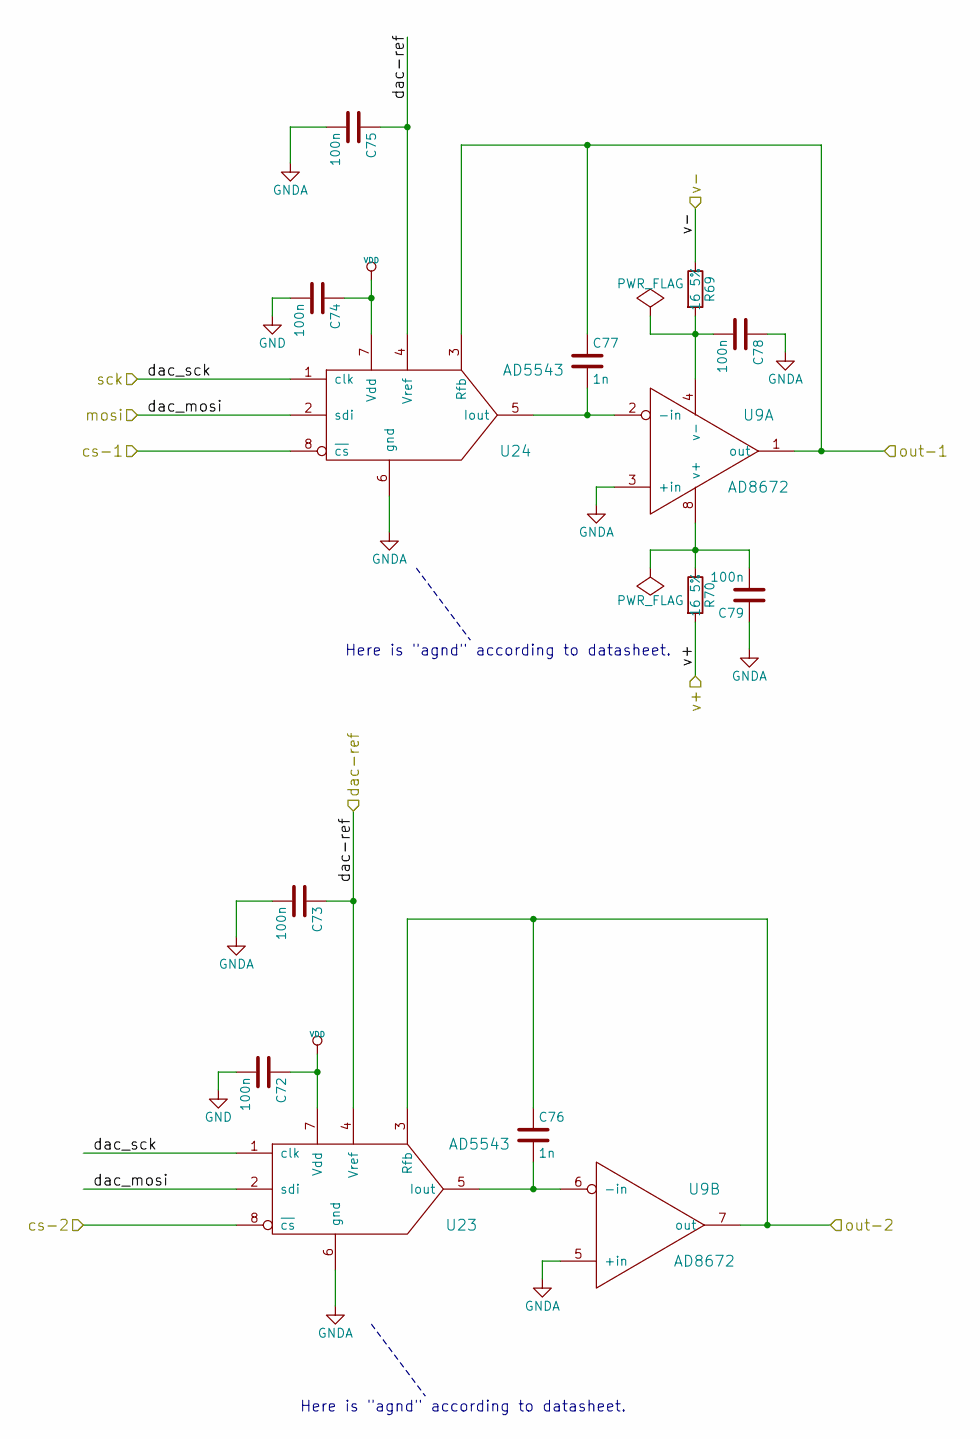
[picture p38: schematic dac-v.sch]

Parts:
C64, C65, C66, C67, C70, C71: 100n; C_0805_HandSoldering
C68, C69: 1n; C_0805_HandSoldering
R67, R68: 16 5%; R_0805_HandSoldering
U8: AD8672; SOIC-8_3.9x4.9mm_Pitch1.27mm
U21, U22: AD5543; SOIC-8_3.9x4.9mm_Pitch1.27mm

Connections:
/dac-v-0/cs-1: U22.8 (~cs~); also elsewhere on the board
/dac-v-0/cs-2: U21.8 (~cs~); also elsewhere on the board
/dac-v-0/dac-ref: C65.1, C67.1, U21.4 (Vref), U22.4 (Vref); also elsewhere on the board
/dac-v-0/mosi: U21.2 (sdi), U22.2 (sdi); also elsewhere on the board
/dac-v-0/out-1: C69.1, U8.1 (out), U22.3 (Rfb); also elsewhere on the board
/dac-v-0/out-2: C68.1, U8.7 (out), U21.3 (Rfb); also elsewhere on the board
/dac-v-0/sck: U21.1 (clk), U22.1 (clk); also elsewhere on the board
/dac-v-0/v+: R68.2; also elsewhere on the board
/dac-v-0/v-: R67.1; also elsewhere on the board
GND: C64.2, C66.2; also elsewhere on the board
GNDA: C65.2, C67.2, C70.1, C71.1, U8.3 (+in), U8.5 (+in), U21.6 (gnd), U22.6 (gnd); also elsewhere on the board
unnamed: C68.2, U8.6 (-in), U21.5 (Iout)
unnamed: C69.2, U8.2 (-in), U22.5 (Iout)
unnamed: C70.2, R67.2, U8.4 (v-)
unnamed: C71.2, R68.1, U8.8 (v+)
VDD: C64.1, C66.1, U21.7 (Vdd), U22.7 (Vdd); also elsewhere on the board

Parts of its further copies:
C72, C73, C74, C75, C78, C79: 100n; C_0805_HandSoldering
C76, C77: 1n; C_0805_HandSoldering
R69, R70: 16 5%; R_0805_HandSoldering
U9: AD8672; SOIC-8_3.9x4.9mm_Pitch1.27mm
U23, U24: AD5543; SOIC-8_3.9x4.9mm_Pitch1.27mm

Connections of its further copies:
/dac-v-0/dac-ref: C73.1, C75.1, U23.4 (Vref), U24.4 (Vref); also elsewhere on the board
/dac-v-0/v+: R70.2; also elsewhere on the board
/dac-v-0/v-: R69.1; also elsewhere on the board
/dac-v-1/cs-1: U24.8 (~cs~); also elsewhere on the board
/dac-v-1/cs-2: U23.8 (~cs~); also elsewhere on the board
/dac-v-1/mosi: U23.2 (sdi), U24.2 (sdi); also elsewhere on the board
/dac-v-1/out-1: C77.1, U9.1 (out), U24.3 (Rfb); also elsewhere on the board
/dac-v-1/out-2: C76.1, U9.7 (out), U23.3 (Rfb); also elsewhere on the board
/dac-v-1/sck: U23.1 (clk), U24.1 (clk); also elsewhere on the board
GND: C72.2, C74.2; also elsewhere on the board
GNDA: C73.2, C75.2, C78.1, C79.1, U9.3 (+in), U9.5 (+in), U23.6 (gnd), U24.6 (gnd); also elsewhere on the board
unnamed: C76.2, U9.6 (-in), U23.5 (Iout)
unnamed: C77.2, U9.2 (-in), U24.5 (Iout)
unnamed: C78.2, R69.2, U9.4 (v-)
unnamed: C79.2, R70.1, U9.8 (v+)
VDD: C72.1, C74.1, U23.7 (Vdd), U24.7 (Vdd); also elsewhere on the board

Notes on the sheet:
Here is "agnd" according to datasheet.

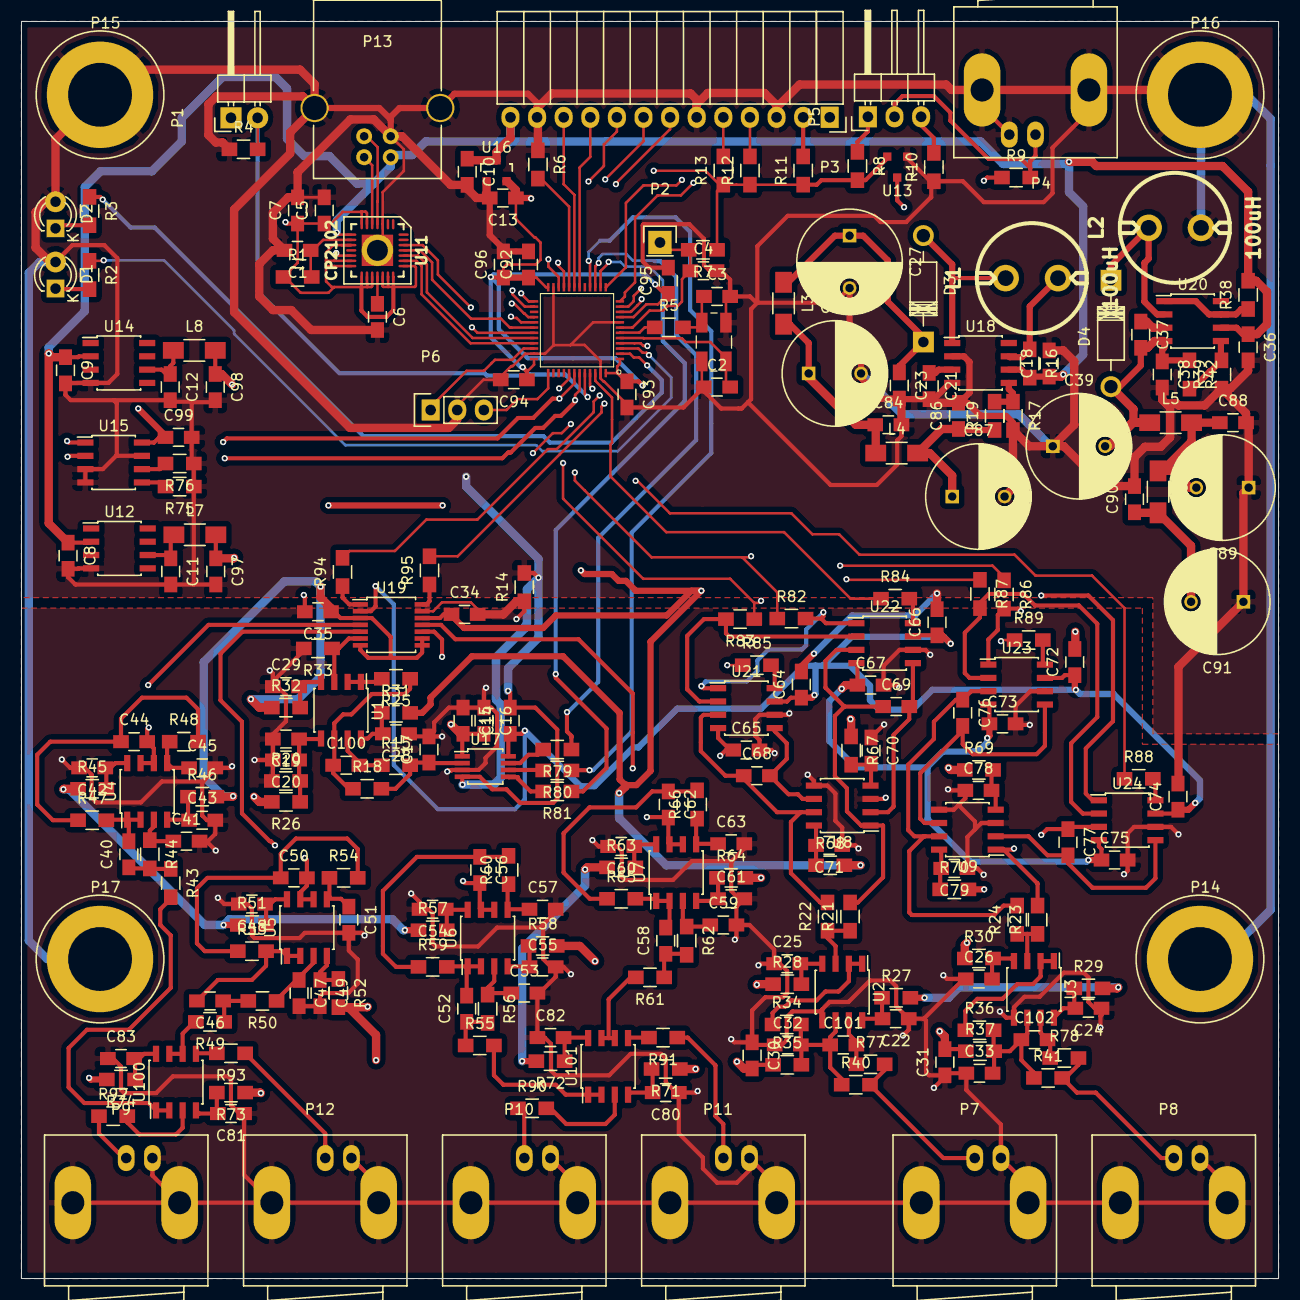
[picture p39: board digitizer.kicad_pcb from above]

Board: 4 copper layers, 120.0 x 120.0 mm, 253 parts (0 on the bottom side), 163 nets.
