z80/digitizer/software/libio/src/voltamp_io.cpp

#include "voltamp_io.h"
#include "io.h"

class Sleep: public QThread
{
public:
    Sleep()
        : QThread()
    {
    }

    ~Sleep()
    {
    }

    static void msleep( int ms )
    {
        QThread::msleep( ms );
    }
};



class VoltampIo::PD
{
public:
    PD()
    {
    }

    ~PD()
    {
    }

    void    encodeData( quint8 * data, int sz );
    quint32 msToTicks( qreal ms );
    QMutex mutex;
    Io * io;
    QByteArray buffer_raw;
    QByteArray buffer_cmd;
    QByteArray buffer;

    static const int CMD_SET_ARGS;
    static const int CMD_EXEC_FUNC;

    static const int TIMEOUT;
    static const int IN_BUFFER_SZ;
};

const int VoltampIo::PD::CMD_SET_ARGS  = 1;
const int VoltampIo::PD::CMD_EXEC_FUNC = 2;

const int VoltampIo::PD::TIMEOUT = 6000;
const int VoltampIo::PD::IN_BUFFER_SZ = (640 * 16); //(4 * 2048);

void VoltampIo::PD::encodeData( quint8 * data, int sz )
{
    QByteArray & arr = buffer;
    arr.reserve( sz * 2 + 2 );
    arr.clear();
    for ( int i=0; i<sz; i++ )
    {
        if ( ( data[i] == '\\' ) || ( data[i] == '\0' ) )
            arr.append( '\\' );
        arr.append( data[i] );
    }
    arr.append( '\0' );
}

quint32 VoltampIo::PD::msToTicks( qreal ms )
{
    quint32 ticks = static_cast<quint32>( ms * 24000.0 / (3*239.5*16.0) );
    return ticks;
}

VoltampIo::VoltampIo()
{
    pd = new PD;
    pd->io = new Io();
}

VoltampIo::~VoltampIo()
{
    delete pd->io;
    delete pd;
}

QStringList VoltampIo::enumDevices()
{
    QStringList l = pd->io->enumDevices();
    return l;
}

bool VoltampIo::open( int index )
{
    QMutexLocker lock( &pd->mutex );

    bool res = pd->io->open( index );
    return res;
}

bool VoltampIo::isOpen() const
{
    QMutexLocker lock( &pd->mutex );

    bool res = pd->io->isOpen();
    return res;
}

void VoltampIo::close()
{
    QMutexLocker lock( &pd->mutex );

    pd->io->close();
}

bool VoltampIo::hardware_version( QString & stri )
{
    QMutexLocker lock( &pd->mutex );

    quint8 funcInd = 0;
    bool res = execFunc( funcInd );
    //if ( !res )
    //    return false;

    QByteArray & arr = pd->buffer;
    arr.resize( PD::IN_BUFFER_SZ );
    bool eom;
    int cnt = read( reinterpret_cast<quint8 *>( arr.data() ), arr.size(), eom );
    if ( !eom )
        return false;
    stri.clear();
    for ( int i=0; i<cnt; i++ )
        stri.append( QChar( arr.at( i ) ) );
    return true;
}

bool VoltampIo::firmware_version( QString & stri )
{
    QMutexLocker lock( &pd->mutex );

    quint8 funcInd = 1;
    bool res = execFunc( funcInd );
    if ( !res )
        return false;

    QByteArray & arr = pd->buffer;
    arr.resize( PD::IN_BUFFER_SZ );
    bool eom;
    int cnt = read( reinterpret_cast<quint8 *>( arr.data() ), arr.size(), eom );
    if ( !eom )
        return false;
    stri.clear();
    for ( int i=0; i<cnt; i++ )
        stri.append( QChar( arr.at( i ) ) );
    return true;
}

bool VoltampIo::setLed( int leds )
{
    QMutexLocker lock( &pd->mutex );

    quint8 v;
    v = static_cast<quint8>( leds & 0xFF );

    bool res;
    res = setArgs( &v, 1 );
    if ( !res )
        return false;

    quint8 funcInd = 2;
    res = execFunc( funcInd );
    if ( !res )
        return false;

    return true;
}

bool VoltampIo::setDac1( int dacA, int dacB )
{
    QMutexLocker lock( &pd->mutex );

    QByteArray & b = pd->buffer_raw;
    b.clear();
    b.reserve( 4 );

    quint8 v;
    v = static_cast<quint8>( dacA & 0xFF );
    b.append( *reinterpret_cast<char *>(&v) );
    v = static_cast<quint8>( (dacA >> 8) & 0xFF );
    b.append( *reinterpret_cast<char *>(&v) );
    v = static_cast<quint8>( dacB & 0xFF );
    b.append( *reinterpret_cast<char *>(&v) );
    v = static_cast<quint8>( (dacB >> 8) & 0xFF );
    b.append( *reinterpret_cast<char *>(&v) );

    bool res;
    res = setArgs( reinterpret_cast<quint8 *>( b.data() ), b.size() );
    if ( !res )
        return false;

    quint8 funcInd = 3;
    res = execFunc( funcInd );
    if ( !res )
        return false;

    return true;
}

bool VoltampIo::setDac2( int dacA, int dacB )
{
    QMutexLocker lock( &pd->mutex );

    QByteArray & b = pd->buffer_raw;
    b.clear();
    b.reserve( 4 );

    quint8 v;
    v = static_cast<quint8>( dacA & 0xFF );
    b.append( *reinterpret_cast<char *>(&v) );
    v = static_cast<quint8>( (dacA >> 8) & 0xFF );
    b.append( *reinterpret_cast<char *>(&v) );
    v = static_cast<quint8>( dacB & 0xFF );
    b.append( *reinterpret_cast<char *>(&v) );
    v = static_cast<quint8>( (dacB >> 8) & 0xFF );
    b.append( *reinterpret_cast<char *>(&v) );

    bool res;
    res = setArgs( reinterpret_cast<quint8 *>( b.data() ), b.size() );
    if ( !res )
        return false;

    quint8 funcInd = 4;
    res = execFunc( funcInd );
    if ( !res )
        return false;

    return true;
}

bool VoltampIo::instantAdc( int * data )
{
    QMutexLocker lock( &pd->mutex );

    quint8 funcInd = 5;
    bool res = execFunc( funcInd );
    if ( !res )
        return false;

    QByteArray & arr = pd->buffer;
    arr.resize( PD::IN_BUFFER_SZ );
    bool eom;
    int cnt = read( reinterpret_cast<quint8 *>( arr.data() ), arr.size(), eom );
    if ( ( !eom ) || ( cnt < 8 ) )
        return false;

    for ( int i=0; i<4; i++ )
    {
        quint8 * d = reinterpret_cast<quint8 *>( arr.data() );
        d += i*2;
        int val = static_cast<int>( d[0] );
        val    += (static_cast<int>( d[1] ) << 8);
        /*
        val    += (static_cast<int>( d[2] ) << 16);
        val    += (static_cast<int>( d[3] ) << 24);
        */
        data[i] = val;
    }
    
    return true;
}

bool VoltampIo::setOscSignals( bool * en )
{
    QMutexLocker lock( &pd->mutex );

    quint8 funcInd = 6;
    bool res = execFunc( funcInd );
    if ( !res )
        return false;
    quint8 v = ( (en[0] ? 1 : 0) | (en[1] ? 2 : 0) | (en[2] ? 4 : 0) | (en[3] ? 8 : 0) );
    res = setArgs( &v, 1 );
    if ( !res )
        return false;
    return true;
}

bool VoltampIo::setOscPeriod( int ptsCnt, qreal periodMs )
{
    QMutexLocker lock( &pd->mutex );

    // Adc timer frequency is 100kHz. So each signal is suppsed to 
    // be measured with frequency 25kHz.
    // One time tick is 20e3[us/s]/25e3[tick/s] = 40[us/tick] = 0.04[ms/tick].
    qreal period = ( periodMs * 4.0 )/ static_cast<qreal>( ptsCnt );
    quint32 periodI = static_cast<quint32>( period );
    quint8  v[4];
    v[0] = static_cast<quint8>( periodI & 0xFF );
    v[1] = static_cast<quint8>( (periodI >> 8) & 0xFF );
    v[2] = static_cast<quint8>( (periodI >> 16) & 0xFF );
    v[3] = static_cast<quint8>( (periodI >> 24) & 0xFF );

    bool res;
    res = setArgs( reinterpret_cast<quint8 *>( v ), 4 );
    if ( !res )
        return false;

    quint8 funcInd = 7;
    res = execFunc( funcInd );
    if ( !res )
        return false;

    return true;
}

bool VoltampIo::oscData( QVector<int> & data )
{
    QMutexLocker lock( &pd->mutex );

    quint8 funcInd = 8;
    bool res = execFunc( funcInd );
    if ( !res )
        return false;
    bool eom;
    QByteArray & arr = pd->buffer;
    arr.resize( PD::IN_BUFFER_SZ );
    int cnt = read( reinterpret_cast<quint8 *>( arr.data() ), arr.size(), eom );
    if ( !eom )
        return false;

    int sz = cnt / 2;
    data.resize( sz );
    quint8 * d = reinterpret_cast<quint8 *>( arr.data() );
    for ( int i=0; i<sz; i++ )
    {
        int v;
        v  = static_cast<int>( d[2*i] );
        v += static_cast<int>( d[2*i+1] << 8 );
        //v += static_cast<int>( d[3*i+2] << 16 );
        //if ( v & 0x8000 )
        //    v = v - 65535;
        data[i] = v;
    }

    return true;
}

bool VoltampIo::temperature( qreal & temp )
{
    QMutexLocker lock( &pd->mutex );

    quint8 funcInd = 9;
    bool res = execFunc( funcInd );
    if ( !res )
        return false;
    bool eom;
    QByteArray & arr = pd->buffer;
    arr.resize( PD::IN_BUFFER_SZ );
    int cnt = read( reinterpret_cast<quint8 *>( arr.data() ), arr.size(), eom );
    if ( !eom )
        return false;

    const quint8 * data = reinterpret_cast<const quint8 *>( arr.data() );
    int rawt = (static_cast<int>(data[0]) << 8) + static_cast<int>(data[1]);
    rawt = (rawt & 0x8000) ? (rawt-65536) : rawt;
    temp = static_cast<qreal>( rawt ) / 128.0;
    return true;
}

bool VoltampIo::setTriggerEn( bool en )
{
    QMutexLocker lock( &pd->mutex );

    quint8 v = en ? 1 : 0;
    bool res;
    res = setArgs( reinterpret_cast<quint8 *>( &v ), 1 );
    if ( !res )
        return false;

    quint8 funcInd = 10;
    res = execFunc( funcInd );
    if ( !res )
        return false;

    return true;
}

bool VoltampIo::setSweepRange( int * dacTo )
{
    QMutexLocker lock( &pd->mutex );

    quint8 dacs[8];
    for ( int i=0; i<4; i++ )
    {
        dacs[2*i]   = static_cast<quint8>( (dacTo[i] >> 8) & 0xFF );
        dacs[2*i+1] = static_cast<quint8>(dacTo[i] &0xFF);
    }


    bool res;
    res = setArgs( reinterpret_cast<quint8 *>( dacs ), 8 );
    if ( !res )
        return false;

    quint8 funcInd = 11;
    res = execFunc( funcInd );
    if ( !res )
        return false;

    return true;
}

bool VoltampIo::setSweepTime( int ptsCnt, int period )
{
    QMutexLocker lock( &pd->mutex );

    quint8 args[8];
    args[0] = static_cast<quint8>( (ptsCnt >> 24) & 0xFF );
    args[1] = static_cast<quint8>( (ptsCnt >> 16) & 0xFF );
    args[2] = static_cast<quint8>( (ptsCnt >> 8) & 0xFF );
    args[3] = static_cast<quint8>( ptsCnt & 0xFF );

    args[4] = static_cast<quint8>( (period >> 24) & 0xFF );
    args[5] = static_cast<quint8>( (period >> 16) & 0xFF );
    args[6] = static_cast<quint8>( (period >> 8) & 0xFF );
    args[7] = static_cast<quint8>( period & 0xFF );

    bool res;
    res = setArgs( reinterpret_cast<quint8 *>( args ), 8 );
    if ( !res )
        return false;

    quint8 funcInd = 12;
    res = execFunc( funcInd );
    if ( !res )
        return false;

    return true;
}

bool VoltampIo::setSweepEn( bool en )
{
    QMutexLocker lock( &pd->mutex );

    quint8 v = en ? 1 : 0;
    bool res;
    res = setArgs( reinterpret_cast<quint8 *>( &v ), 1 );
    if ( !res )
        return false;

    quint8 funcInd = 13;
    res = execFunc( funcInd );
    if ( !res )
        return false;

    return true;
}

bool VoltampIo::sweepEn( bool & en )
{
    QMutexLocker lock( &pd->mutex );

    quint8 funcInd = 14;
    bool res = execFunc( funcInd );
    if ( !res )
        return false;

    QByteArray & arr = pd->buffer;
    arr.resize( PD::IN_BUFFER_SZ );
    bool eom;
    int cnt = read( reinterpret_cast<quint8 *>( arr.data() ), arr.size(), eom );
    if ( !eom )
        return false;

    en = (arr.data()[0] != 0);

    return true;
}

bool VoltampIo::sweepData( QVector<int> & data )
{
    QMutexLocker lock( &pd->mutex );

    quint8 funcInd = 15;
    bool res = execFunc( funcInd );
    if ( !res )
        return false;
    bool eom;
    QByteArray & arr = pd->buffer;
    arr.resize( PD::IN_BUFFER_SZ );
    int cnt = read( reinterpret_cast<quint8 *>( arr.data() ), arr.size(), eom );
    if ( !eom )
        return false;

    int sz = cnt / 2;
    data.resize( sz );
    quint8 * d = reinterpret_cast<quint8 *>( arr.data() );
    for ( int i=0; i<sz; i++ )
    {
        int v;
        v  = static_cast<int>( d[2*i] );
        v += static_cast<int>( d[2*i+1] << 8 );
        //v += static_cast<int>( d[3*i+2] << 16 );
        //if ( v & 0x8000 )
        //    v = v - 65535;
        data[i] = v;
    }

    return true;
}

bool VoltampIo::sweepPush( int ptsCnt, int period, int * dacsTo )
{
    QMutexLocker lock( &pd->mutex );

    quint8 dacs[16];

    dacs[0] = static_cast<quint8>((ptsCnt >> 24) & 0xFF);
    dacs[1] = static_cast<quint8>((ptsCnt >> 16) & 0xFF);
    dacs[2] = static_cast<quint8>((ptsCnt >> 8) & 0xFF);
    dacs[3] = static_cast<quint8>(ptsCnt & 0xFF);

    dacs[4] = static_cast<quint8>((period >> 24) & 0xFF);
    dacs[5] = static_cast<quint8>((period >> 16) & 0xFF);
    dacs[6] = static_cast<quint8>((period >> 8) & 0xFF);
    dacs[7] = static_cast<quint8>(period & 0xFF);

    for ( int i=0; i<4; i++ )
    {
        dacs[8+2*i]   = static_cast<quint8>( (dacsTo[i] >> 8) & 0xFF );
        dacs[8+2*i+1] = static_cast<quint8>(dacsTo[i] &0xFF);
    }

    bool res;
    res = setArgs( reinterpret_cast<quint8 *>( dacs ), 16 );
    if ( !res )
        return false;

    quint8 funcInd = 20;
    res = execFunc( funcInd );
    if ( !res )
        return false;

    return true;
}

bool VoltampIo::sweepQueueSize( int & size )
{
    QMutexLocker lock( &pd->mutex );

    quint8 funcInd = 21;
    bool res = execFunc( funcInd );
    if ( !res )
        return false;

    bool eom;
    QByteArray & arr = pd->buffer;
    arr.resize( PD::IN_BUFFER_SZ );
    int cnt = read( reinterpret_cast<quint8 *>( arr.data() ), arr.size(), eom );
    if ( ( !eom ) || (cnt < 4) )
        return false;

    quint8 * d = reinterpret_cast<quint8 *>( arr.data() );
    cnt = static_cast<int>(d[0]) + 
          ( static_cast<int>(d[1]) << 8 ) + 
          ( static_cast<int>(d[2]) << 16 ) + 
          ( static_cast<int>(d[3]) << 24 );

    size = cnt;
    return true;
}

bool VoltampIo::setOutput( int o )
{
    QMutexLocker lock( &pd->mutex );

    quint8 v = static_cast<quint8>( o );
    bool res;
    res = setArgs( reinterpret_cast<quint8 *>( &v ), 1 );
    if ( !res )
        return false;

    quint8 funcInd = 16;
    res = execFunc( funcInd );
    if ( !res )
        return false;

    return true;

}

bool VoltampIo::runBootloader()
{
    QMutexLocker lock( &pd->mutex );

    // Should execute function. The function is supposed
    // to send back acknowledge data and jump to
    // upgrade firmware.
    quint8 funcInd = 17;
    bool res = execFunc( funcInd );
    if ( !res )
        return false;

    bool eom;
    QByteArray & arr = pd->buffer;
    arr.resize( PD::IN_BUFFER_SZ );
    int cnt = read( reinterpret_cast<quint8 *>( arr.data() ), arr.size(), eom );
    if ( !eom )
        return false;

    // Check for "ok" response.
    if ( !( ( arr[0] == 'o' ) && ( arr[1] == 'k' ) ) )
        return false;

    Sleep::msleep( 500 );
    return true;
}

bool VoltampIo::bootloaderHardwareVersion( QString & stri )
{
    QMutexLocker lock( &pd->mutex );

    quint8 funcInd = 0 + 128;
    bool res = execFunc( funcInd );
    if ( !res )
        return false;

    QByteArray & arr = pd->buffer;
    arr.resize( PD::IN_BUFFER_SZ );
    bool eom;
    int cnt = read( reinterpret_cast<quint8 *>( arr.data() ), arr.size(), eom );
    if ( !eom )
        return false;
    stri.clear();
    for ( int i=0; i<cnt; i++ )
        stri.append( QChar( arr.at( i ) ) );

    Sleep::msleep( 500 );

    return true;
}


bool VoltampIo::bootloaderFirmwareVersion( QString & stri )
{
    QMutexLocker lock( &pd->mutex );

    quint8 funcInd = 1 + 128;
    bool res = execFunc( funcInd );
    if ( !res )
        return false;

    QByteArray & arr = pd->buffer;
    arr.resize( PD::IN_BUFFER_SZ );
    bool eom;
    int cnt = read( reinterpret_cast<quint8 *>( arr.data() ), arr.size(), eom );
    if ( !eom )
        return false;
    stri.clear();
    for ( int i=0; i<cnt; i++ )
        stri.append( QChar( arr.at( i ) ) );

    Sleep::msleep( 500 );

    return true;
}

bool VoltampIo::bootloaderPush( int cnt, quint8 * data )
{
    bool res;

    const int SZ = 32;
    quint8 args[ SZ ];
    args[0] = static_cast<quint8>( cnt );
    for ( int i=0; i<cnt; i++ )
        args[i+1] = data[i];

    res = setArgs( reinterpret_cast<quint8 *>( args ), cnt+1 );
    if ( !res )
        return false;

    quint8 funcInd = 3 + 128;
    res = execFunc( funcInd );
    if ( !res )
        return false;

    return true;

}

bool VoltampIo::bootloaderWriteSector( int index )
{
    quint8 args[2];
    args[0] = static_cast<quint8>( (index >> 8) & 0xFF );
    args[1] = static_cast<quint8>( index & 0xFF );

    bool res = setArgs( reinterpret_cast<quint8 *>( args ), 2 );
    if ( !res )
        return false;


    quint8 funcInd = 4 + 128;
    res = execFunc( funcInd );
    if ( !res )
        return false;
    bool eom;
    QByteArray & arr = pd->buffer;
    arr.resize( PD::IN_BUFFER_SZ );
    int cnt = read( reinterpret_cast<quint8 *>( arr.data() ), arr.size(), eom );
    if ( !eom )
        return false;

    quint8 errCode = arr.at( 0 );
    if ( errCode != 0 )
        return false;

    return true;
}

bool VoltampIo::bootloaderStartFirmware()
{
    quint8 funcInd = 5 + 128;
    bool res = execFunc( funcInd );
    if ( !res )
        return false;

    return true;
}


bool VoltampIo::firmwareUpgrade( const QString & fileName )
{
    QMutexLocker lock( &pd->mutex );

    const int SECTOR_SZ = 1024;
    const int PACKET_SZ = 8;

    quint8 packet[ PACKET_SZ ];

    QFile f( fileName );
    if ( !f.open( QIODevice::ReadOnly ) )
        return false;

    bool res;
    int totalCnt = 0;
    int sectorIndex  = 0;
    while ( !f.atEnd() )
    {
        int cnt = f.read( reinterpret_cast<char *>( packet ), PACKET_SZ );
        if ( cnt >= 1 )
        {
            res = bootloaderPush( cnt, packet );
            if ( !res )
                return false;

            totalCnt += cnt;

            if ( totalCnt >= SECTOR_SZ )
            {
                res = bootloaderWriteSector( sectorIndex );
                if ( !res )
                    return false;
                sectorIndex += 1;
                totalCnt -= SECTOR_SZ;
            }
        }
    }

    f.close();

    if ( totalCnt > 0 )
    {
        res = bootloaderWriteSector( sectorIndex );
        if ( !res )
            return false;
    }

    res = bootloaderStartFirmware();
    if ( !res )
        return false;

    Sleep::msleep( 500 );

    return true;
}

bool VoltampIo::setSweepDacMode( bool en )
{
    QMutexLocker lock( &pd->mutex );

    quint8 v = static_cast<quint8>( en ? 1 : 0 );
    bool res;
    res = setArgs( reinterpret_cast<quint8 *>( &v ), 1 );
    if ( !res )
        return false;

    quint8 funcInd = 18;
    res = execFunc( funcInd );
    if ( !res )
        return false;

    return true;

}

bool VoltampIo::sweepDacMode( bool & en )
{
    QMutexLocker lock( &pd->mutex );

    quint8 funcInd = 19;
    bool res = execFunc( funcInd );
    if ( !res )
        return false;

    QByteArray & arr = pd->buffer;
    arr.resize( PD::IN_BUFFER_SZ );
    bool eom;
    int cnt = read( reinterpret_cast<quint8 *>( arr.data() ), arr.size(), eom );
    if ( !eom )
        return false;

    en = (arr.data()[0] != 0);

    return true;
}






























bool VoltampIo::setArgs( quint8 * data, int dataSz )
{
    QByteArray & arr = pd->buffer_cmd;
    arr.reserve( dataSz + 1 );
    arr.clear();
    quint8 cmd = static_cast<quint8>( PD::CMD_SET_ARGS );
    arr.append( *reinterpret_cast<char *>( &cmd ) );
    arr.append( reinterpret_cast<char *>(data), dataSz );
    pd->encodeData( reinterpret_cast<quint8 *>(arr.data()), arr.size() );
    int cnt = write( reinterpret_cast<quint8 *>( pd->buffer.data() ), pd->buffer.size() );
    return ( cnt == pd->buffer.size() );
}

bool VoltampIo::execFunc( quint16 funcId )
{
    QByteArray & arr = pd->buffer_cmd;
    arr.reserve( 2 + 1 );
    arr.clear();
    quint8 cmd = static_cast<quint8>( PD::CMD_EXEC_FUNC );
    arr.append( *reinterpret_cast<char *>( &cmd ) );
    cmd = static_cast<quint8>( funcId & 0xFF );
    arr.append( cmd );
    cmd = static_cast<quint8>( (funcId >> 8) & 0xFF );
    arr.append( cmd );
    pd->encodeData( reinterpret_cast<quint8 *>(arr.data()), arr.size() );
    int cnt = write( reinterpret_cast<quint8 *>( pd->buffer.data() ), pd->buffer.size() );
    return ( cnt == pd->buffer.size() );
}

int VoltampIo::readData( quint8 * data, int dataSz )
{
    bool eom;
    int cnt = read( data, dataSz, eom );
    if ( !eom )
        return -1;
    return cnt;
}

int VoltampIo::write( quint8 * data, int dataSz )
{
    //pd->encodeData( data, dataSz );
    int cnt = pd->io->write( data, dataSz );
    return cnt;
}

int VoltampIo::read( quint8 * data, int dataSz, bool & eom )
{
    quint8 one;
    QTime t0 = QTime::currentTime();
    t0.start();
    bool slash = false;
    int ind = 0;
    do
    {
        int cnt = pd->io->read( &one, 1 );
        if ( cnt < 1 )
        {
            Sleep::msleep( 1 );
        }
        else
        {
            if ( !slash )
            {
                if ( one == '\\' )
                    slash = true;
                else if ( one == '\0' )
                {
                    eom = true;
                    return ind;
                }
                else
                    data[ind++] = one;
            }
            else
            {
                data[ind++] = one;
                slash = false;
            }
        }
    } while ( ( ind < dataSz ) && ( t0.elapsed() < PD::TIMEOUT ) );
    eom = false;
    return ind;
}
