z80/digitizer/software/digitizer/src/polarization_dlg.h

#ifndef __POLARIZATION_DLG_H_
#define __POLARIZATION_DLG_H_

#include "ui_polarization_dlg.h"

class MainWnd;

class PolarizationDlg: public QDialog
{
    Q_OBJECT
public:
    PolarizationDlg( MainWnd * mainWnd );
    ~PolarizationDlg();

    void setPotential( qreal v );
    qreal potential() const;

    void setDuration( qreal ms );
    qreal duration() const;

    void setMeasureDuraton( qreal t );
    qreal measureDuration() const;

    void setApplyTo( int index );
    int applyTo() const;

    void setPull( bool pull );
    bool pull() const;

private:
    Ui_PolarizationDlg ui;
};



#endif
