z80/digitizer/common/funcs.h

#ifndef __FUNCS_H_
#define __FUNCS_H_

#define C_HDV_VER           0
#define C_FMW_VER           1
#define C_SET_LED           2
#define C_SET_DAC_1         3
#define C_SET_DAC_2         4
#define C_GET_ADC           5
#define C_SET_OSC_SIG       6
#define C_SET_OSC_T         7
#define C_GET_OSC_DATA      8
#define C_SWEEP             9
#define C_SET_SWEEP_OSC     10
#define C_GET_SWEEP_DATA    11
#define C_FMW_UPGRADE       12
#define C_SET_TRIGGER       13
#define C_SET_TRIGGER_SWEEP 14
#define C_SET_TRIGGER_DATA  15

#endif
