z80/digitizer/software/libio/src/io.h

#ifndef __IO_H_
#define __IO_H_

#include <QtCore>

class Io
{
public:
  Io();
  virtual ~Io();

  QStringList enumDevices() const;
  bool open( int index = 0 );
  bool isOpen() const;
  void close();

  int write( quint8 * data, int dataSz );
  int read( quint8 * data, int dataSz, bool tillTimeout = false );

private:
  class PD;
  PD * pd;
};

#endif
