z80/digitizer/(commit log)

2015-07-03 Annotated opamps.
    [dac-v.sch, digitizer.sch, input-filter-attenuator.sch]
2015-07-10 Added capacitors for making opamp driving capacitive load stable.
    [digitizer.kicad_pcb, digitizer.sch]
2015-07-10 Inserted holding screw holes.
    [dac-v.sch, digitizer.kicad_pcb, digitizer.sch, input-filter-attenuator.sch]
2015-07-17 Placed all components. Now routing.
    [dac-v.sch, digitizer.kicad_pcb, digitizer.sch, input-filter-attenuator.sch]
2015-07-20 Routing completed in the very first approximation.
    [digitizer.kicad_pcb]
2015-07-20 Normal BOM could be exported in "File->fabrication" falling menu.
    [digitizer-B_Cu.gbr, digitizer-B_Mask.gbr, digitizer-B_SilkS.gbr, digitizer-Edge_Cuts.gbr, digitizer-F_Cu.gbr, digitizer-F_Mask.gbr, digitizer-F_SilkS.gbr, digitizer-In1_Cu.gbr]
2015-07-20 Inserting BOM into purchassing software.
    [bom.ods]
2015-07-21 Generated gerbers.
    [bom.ods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]
2015-07-21 Prepared for OSHPark.
    [bom.ods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]
2015-07-22 Added firmware.
    [cosmic.stp, raisonance.stp]
2015-08-10 Debugging. SPI callback doesn't want working.
    [adc_ctrl.c, cpu_io.c, halconf.h, main.c, mcuconf.h, timer_ctrl.c]
2015-08-11 Experimenting with different versions.
    [stm_spc56ec74a256s_spc56ec74_minimodule_debug_jtag.cfg, stm_xpc560b64_minimodule_debug_jtag.cfg, stm_xpc560b_spc560d40_minimodule_debug_jtag.cfg, stm_xpc560p_minimodule_40mhz_debug_jtag.cfg, stm_xpc563m64_minimodule_debug_jtag.cfg, stm_xpc564a_spc564a70_minimodule_debug_jtag.cfg, stm_xpc56el_minimodule_lockstep_debug_jtag.cfg]
2015-08-12 It looks like ADC read works. But DAC still doesn't.
    [adc_ctrl.c, board.c, board.h, chconf.h, dac_ctrl.c, halconf.h]
2015-08-12 DAC works. Problem was caused by the fact that command queue was filled faster then it was purged by timer.
    [main.c, timer_ctrl.c]
2015-08-13 Fixed random dac range.
    [calibration_wnd.cpp]
2015-08-13 Made optimezed image. Recorded some data for DACs calibration.
2015-08-13 So actually DAcs work. Just tried plotting least significant one versus voltage. Of course it looked like noise.
    [bipot.cpp, bipot.h, calibration_wnd.cpp, calibration_wnd.h]
2015-08-13 ADC works properly.
2015-08-15 Turned out that microcontroller performance is hardly enough to read 20kHz. And changed input filters into 2-d order + buffer to prevent multiplexor switches problem.
    [input-filter-attenuator.sch]
2015-08-15 Added some improvements. But if just 1kOhm resistor added in between filter and multiplexer it solves switch spike back propagation into filter. And it eliminates mutual signal interference.
    [digitizer.sch, input-filter-attenuator.sch]
2015-08-16 Added temperature sensor. Due to some reason data is quite discrete.
2015-08-17 Simplified ADC ISR.
2015-08-17 Made external interrupt driven sweep.
2015-08-17 Compiler wanted _exit(), _kill() and something else to be implemented. I've changed it to CodeSourcery. Now it doesn't want it :)
    [cpu_io.c, temp_ctrl.c, timer_ctrl.c, voltamp_io.cpp, voltamp_io.h]
2015-08-18 Temperature readout still works. And due to error fixed it works much better.
    [main.c, sweep_ctrl.c, voltamp_io.cpp]
2015-08-18 Made reading osc and sweep data in one and the sampe thread. Going to analyze interrupts lattency via GPIOs.
2015-08-18 Inserted debug output to GPIOs.
2015-08-18 Made interrupt priorities euqal. It still runs.
2015-08-19 Sweep and oscilloscope work with median filtering.
2015-08-19 16kHz timer also works fine.
2015-08-19 Inserted external trigger support.
2015-08-19 Fixed sweep interruption.
2015-08-20 Additional board for sending one of current signals to AFM.
    [relay-board.kicad_pcb, relay-board.sch, zzz.kicad_pcb]
2015-08-21 Fixed bootloader and verified firmware upgrade routine.
    [relay-board.sch]
2015-08-21 In order to work with bootloader and with firmware inserted 500ms pauses in between bootloader commands.
2015-08-22 Soldered one board and attached to main board. It seems like it works.
    [relay-board.kicad_pcb]
2015-08-25 Designing case...
    [031-5431-10rfx.igs, board.FCStd]
2015-08-28 Added washer for holding initially not planned BNC for output to AFM.
    [board.FCStd, bottom.stl, top.stl, washer.FCStd, washer.stl]
2015-08-28 Data with temperature.
2015-08-29 Added DAC data at different temperature.
2015-08-31 Trying to implement DAC calibrations.
2015-09-01 Save calibration file.
2015-09-01 Adjusted calibration file.
2015-09-02 New calibration data gave better precission then previous one.
2015-09-18 Just made current values readable.
2015-09-30 Limited writing buffer size to not overcome TX buffer capacity.
2015-09-30 Returned units conversion. It decreased maximum speed by 0.1Hz. It was 4.9Hz became 4.8Hz.
2016-02-02 Inserted current sweep queue size query function.
2016-02-03 Made a couple of corrections of initial state to make transitions smooth.
    [sweep_ctrl.c]
2016-02-03 Added software version information. Fixed sweep last point(s) obtaining.
    [bipot.cpp, main_wnd.cpp, sweep_wnd.cpp]
2016-02-03 Inserted help window.
2016-02-05 Removed test code. For now with VCP driver reached maximum throughput of 500 points (one points is 4 2-byte words). Going to branch and tru USBXpress driver with higher transfer rates.
2016-02-24 Increased bootloader wait time to 5 seconds. As it seems it is impossible to engage firmwareUpgrade within 3 seconds. serial open procedure takes too long.
    [dfu_ctrl.c, main.c]
2016-02-24 Just in case if LEDs may provide any EMI turn them off when open a device.
    [bipot.cpp, bipot.h, main_wnd.cpp]
2016-06-10 Added flipping potentials, added current gain 1E3, changed software version to 1.0.1.
    [main_wnd.cpp, main_wnd.h, sweep_wnd.cpp]
2016-07-08 Added I(t) recording and flippong output potentials.
    [main_wnd.cpp, main_wnd.h, oscilloscope_wnd.cpp, oscilloscope_wnd.h, sweep_wnd.cpp, sweep_wnd.h]
