z80/digitizer/(notices)

Notices in the files:
software/3dparty/cp2102-26x/cp210x.c:
modify it under the terms of the GNU General Public License version
